josdo/commit-bot/followerschem.png

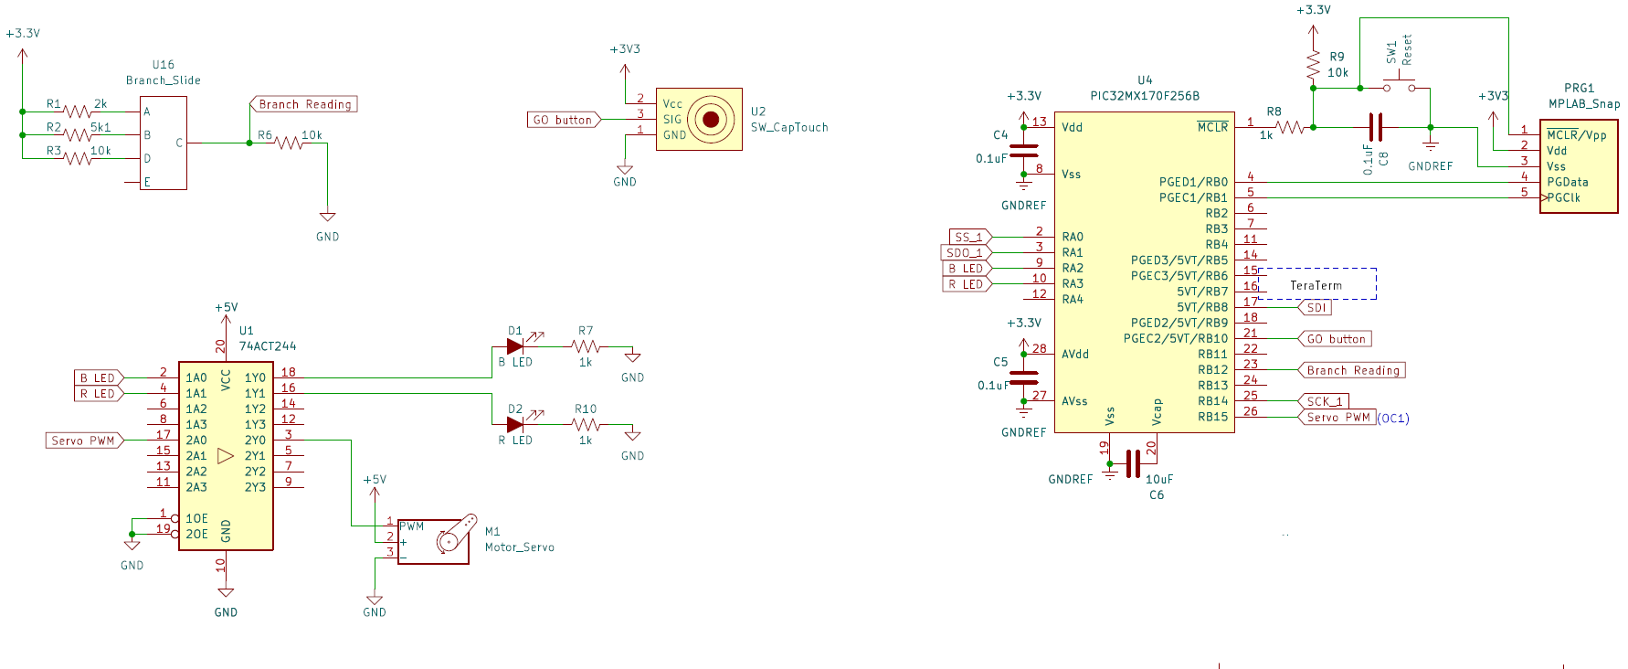
followerschem.png
