josdo/commit-bot/IR.png

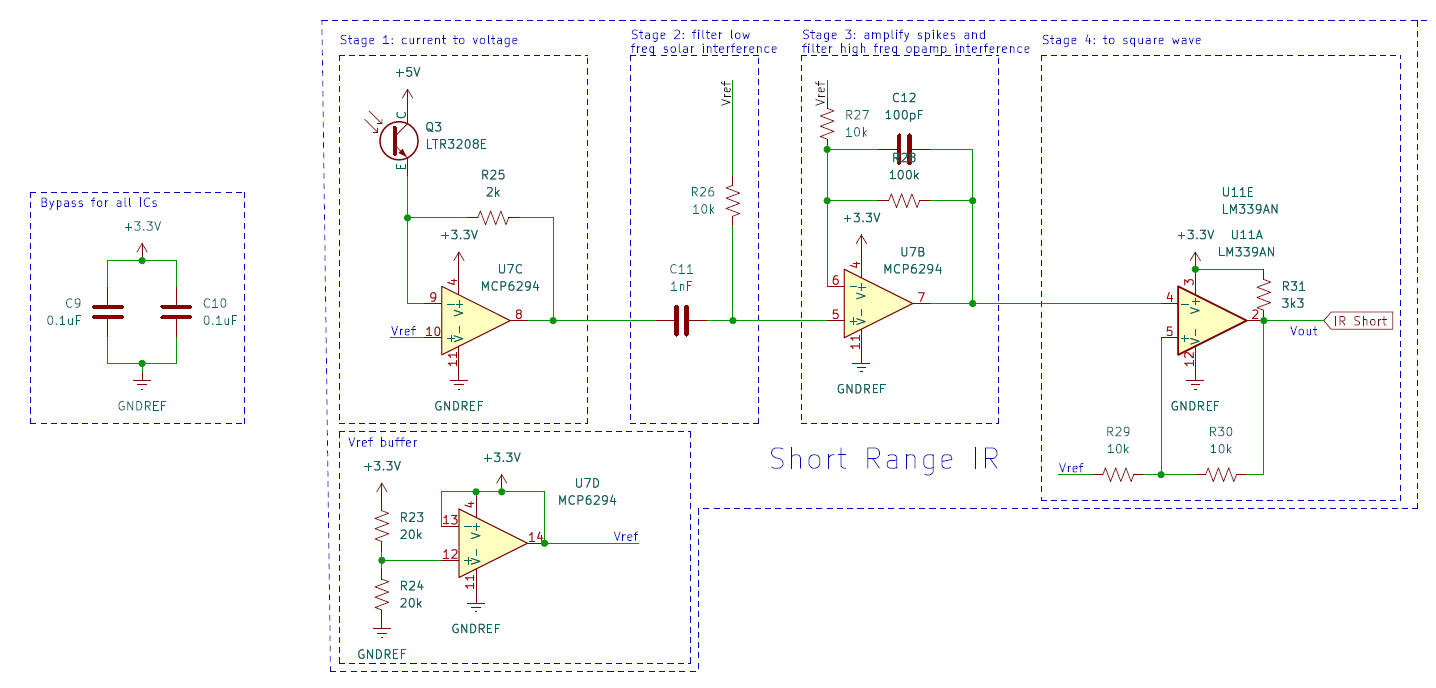
IR.png
