josdo/commit-bot/Leader1.png

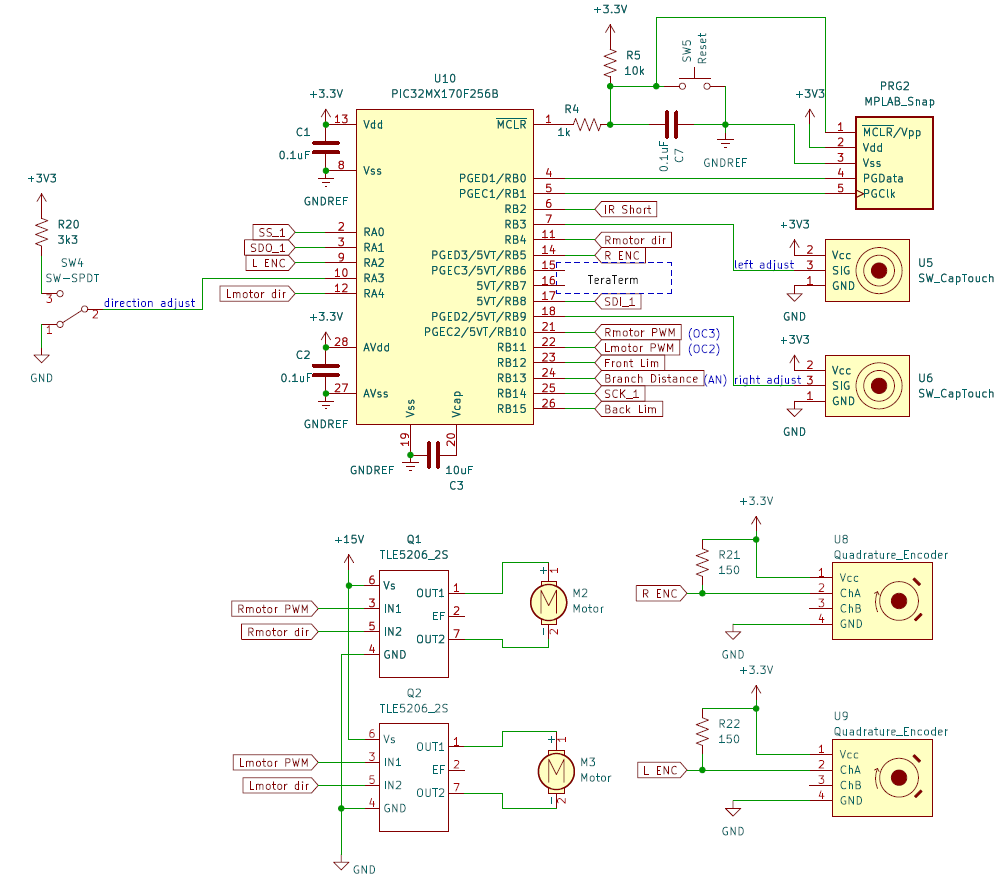
Leader1.png
