josdo/commit-bot/leader2schem.png

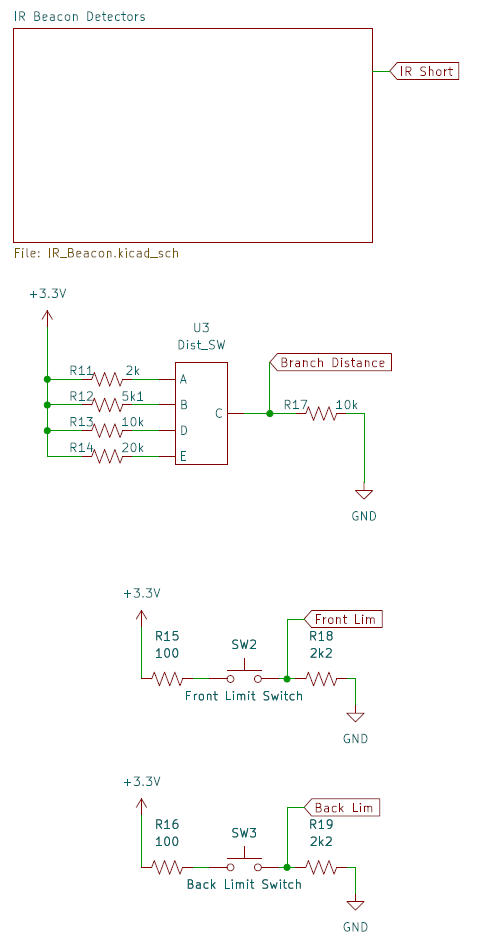
leader2schem.png
