josdo/commit-bot/mechanical/reflect_assem.SLDASM

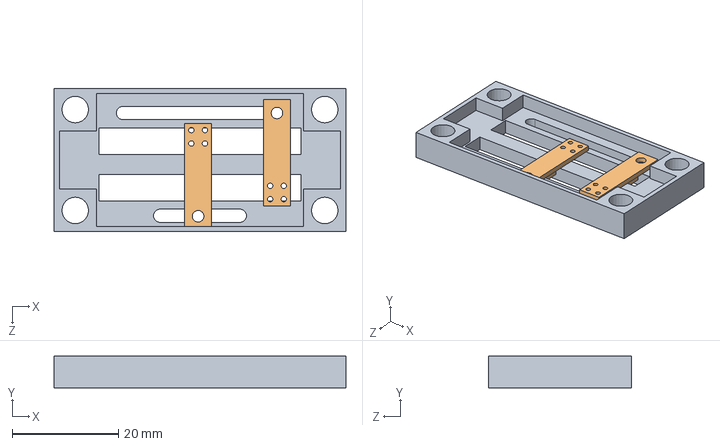
[picture p5: CAD file, 2023-03-14]
mechanical/reflect_assem.SLDASM
55.0 x 6.00 x 27.0 mm
reflectance_holder
Reflectance_Sensor x 2
