josdo/commit-bot/mechanical/NEW_wheel_assem.SLDASM

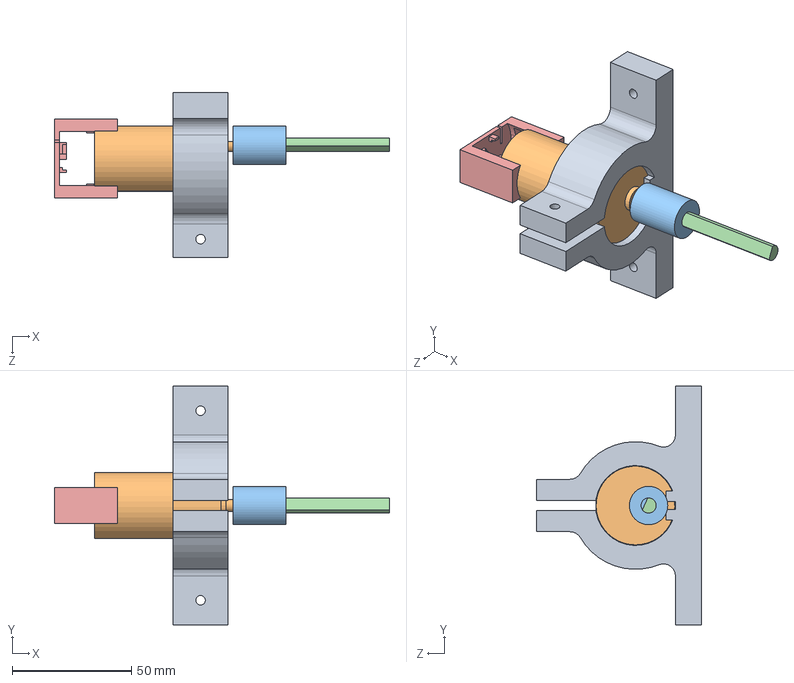
[picture p6: CAD file, 2023-03-14]
mechanical/NEW_wheel_assem.SLDASM
140.4 x 100.0 x 69.2 mm
Motor Mount.ipt
Motor v3.ipt
coupler
drive_shaft
Encoder_BracketMount
