josdo/commit-bot/mechanical/servo_heart.SLDASM

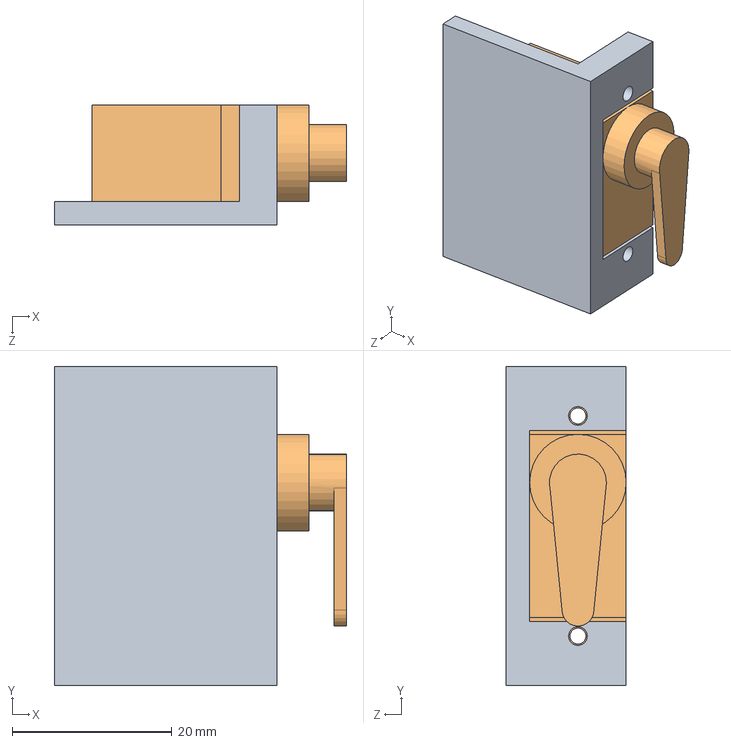
[picture p7: CAD file, 2023-03-13]
mechanical/servo_heart.SLDASM
36.7 x 40.0 x 15.1 mm
servo_holder
servo
