josdo/commit-bot/mechanical/transmission_assem.SLDASM

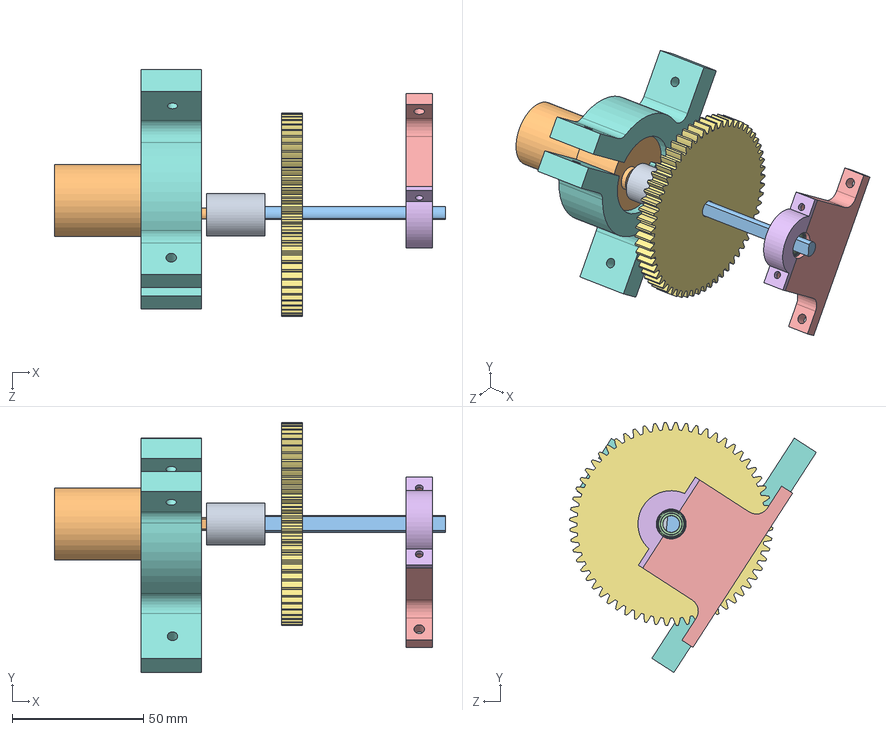
[picture p8: CAD file, 2023-03-08]
mechanical/transmission_assem.SLDASM
149.1 x 95.4 x 94.1 mm
Motor v3.ipt
drive_shaft
coupler
bearing mount
top_bearing_mount
spur gear_am
Mount.ipt
