josdo/commit-bot/mechanical/bearing_mount_assem.SLDASM

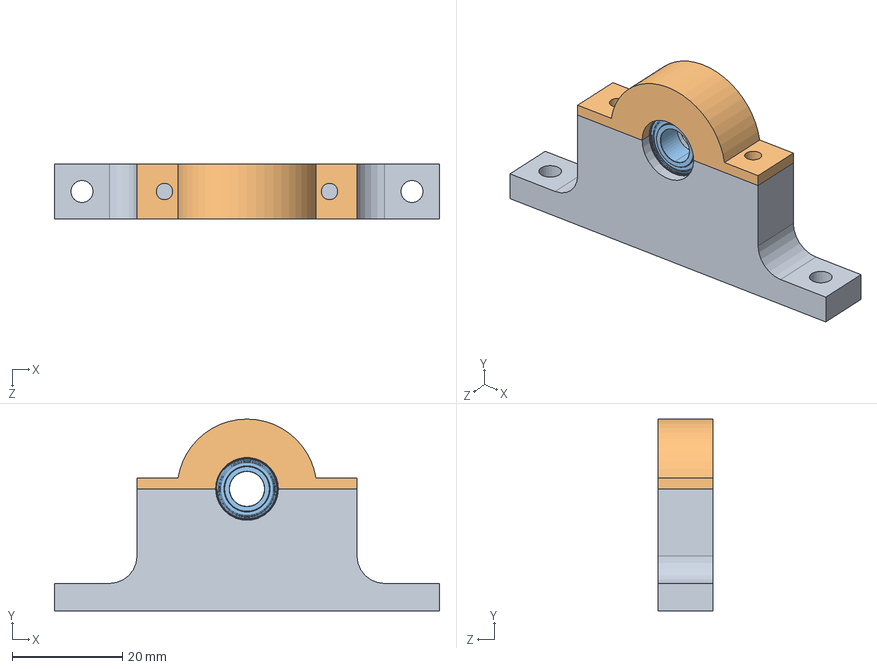
[picture p9: CAD file, 2023-03-08]
mechanical/bearing_mount_assem.SLDASM
70.0 x 34.9 x 10.0 mm
short_bearing_mount
top_bearing_mount
1600-0002-0250.step
