josdo/commit-bot/mechanical/wheel_mount.SLDASM

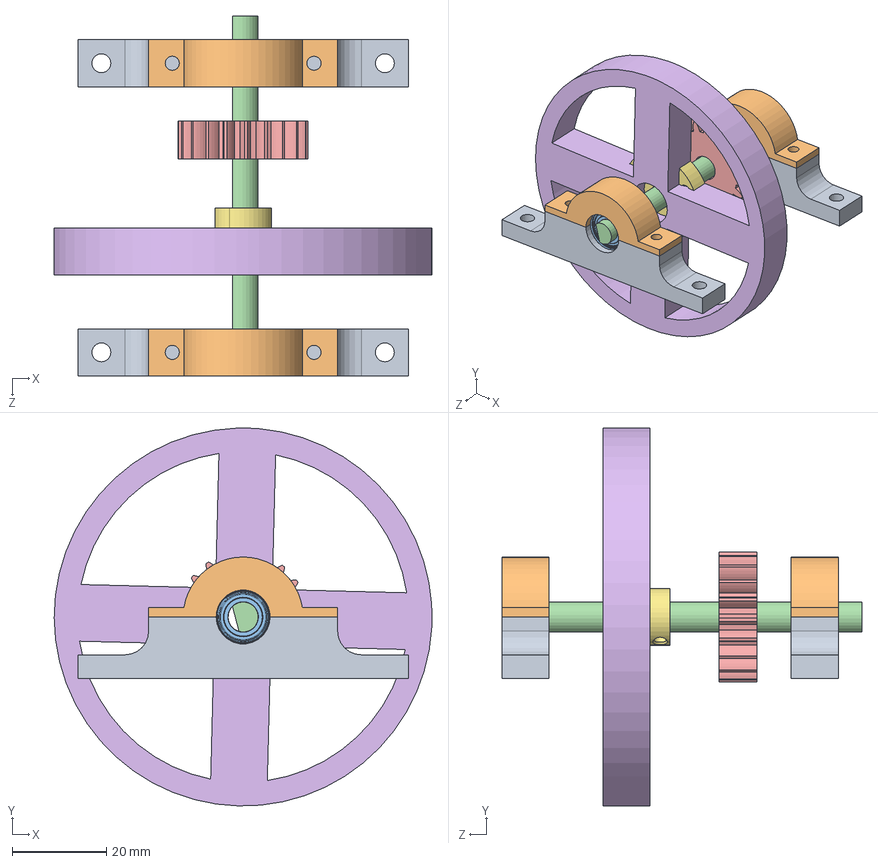
[picture p10: CAD file, 2023-02-17]
mechanical/wheel_mount.SLDASM
79.9 x 80.0 x 76.2 mm
short_bearing_mount x 2
top_bearing_mount x 2
1600-0002-0250.step x 2
drive_shaft
spur gear_am
wheel_80mm
pololu-universal-aluminum-mounting-hub-for-0-25in-shaft-m3-holes.step
