josdo/commit-bot/mechanical/total_robot.SLDASM

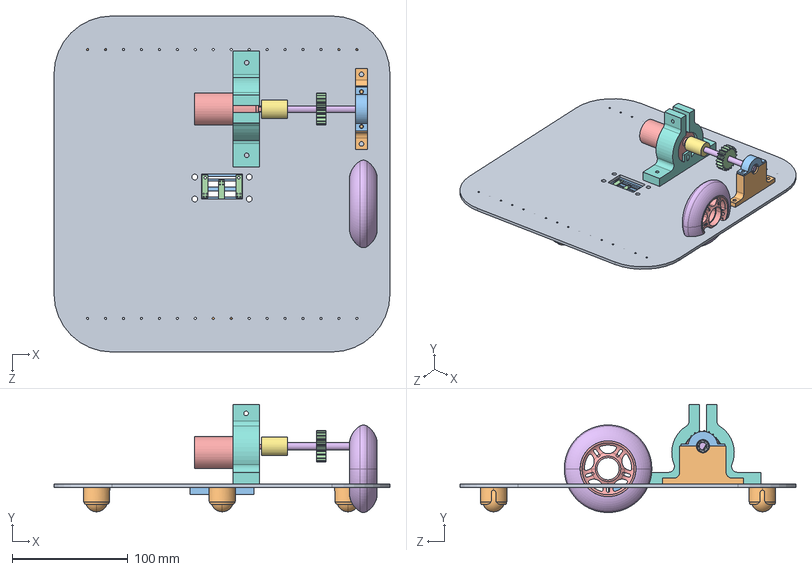
[picture p11: CAD file, 2023-02-16]
mechanical/total_robot.SLDASM
290.0 x 93.2 x 290.0 mm
DEV_bottom_board
pololu-ball-caster-with-0-750in-metal-ball.step x 3
reflectance_holder
Reflectance_Sensor x 3
Motor v3.ipt
drive_shaft
coupler
Mount.ipt
1600-0002-0250.step
bearing mount
top_bearing_mount
spur gear_am
3608-0001-0076 pt1.STEP
3608-0001-0076 pt2.STEP
