josdo/commit-bot/mechanical/3608-0001-0076 assembly.STEP

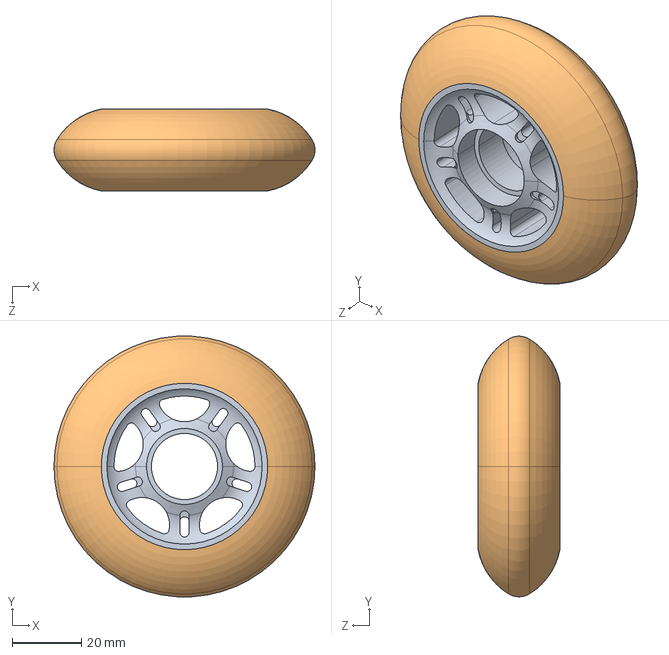
[picture p12: CAD file, 2023-02-16]
mechanical/3608-0001-0076 assembly.STEP
75.5 x 75.4 x 23.7 mm
3608-0001-0076 pt1
3608-0001-0076 pt2
