josdo/commit-bot/mechanical/STLs/right_heart.STL

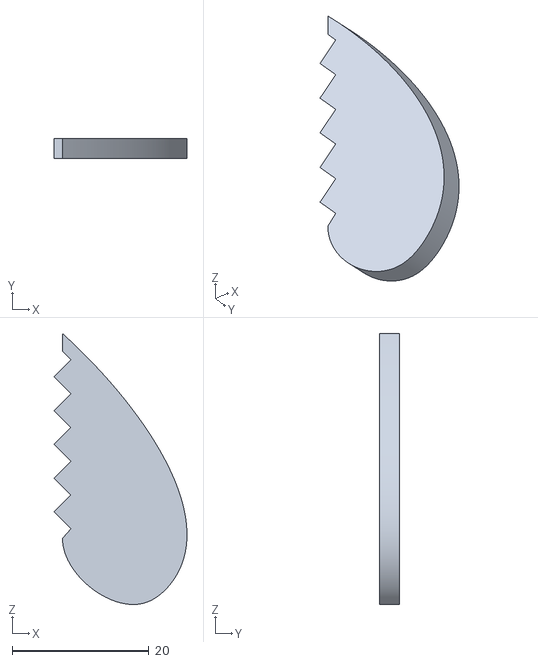
[picture p13: CAD file, 2023-03-13]
mechanical/STLs/right_heart.STL
19.5 x 3.00 x 39.7
