josdo/commit-bot/mechanical/NEW_top_plate.SLDPRT

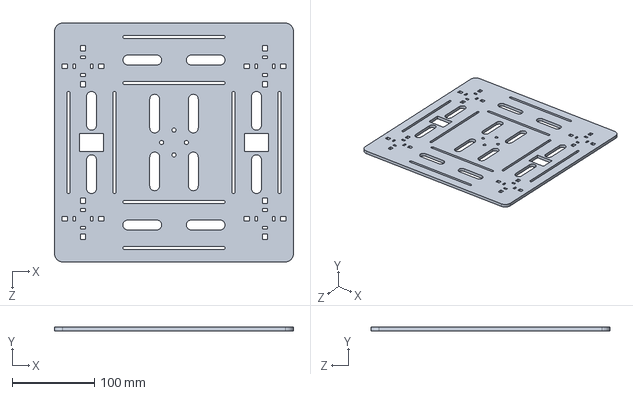
[picture p14: CAD file, 2023-03-14]
mechanical/NEW_top_plate.SLDPRT
290.0 x 4.76 x 290.0 mm
