josdo/commit-bot/mechanical/STLs/spur_D_40.STL

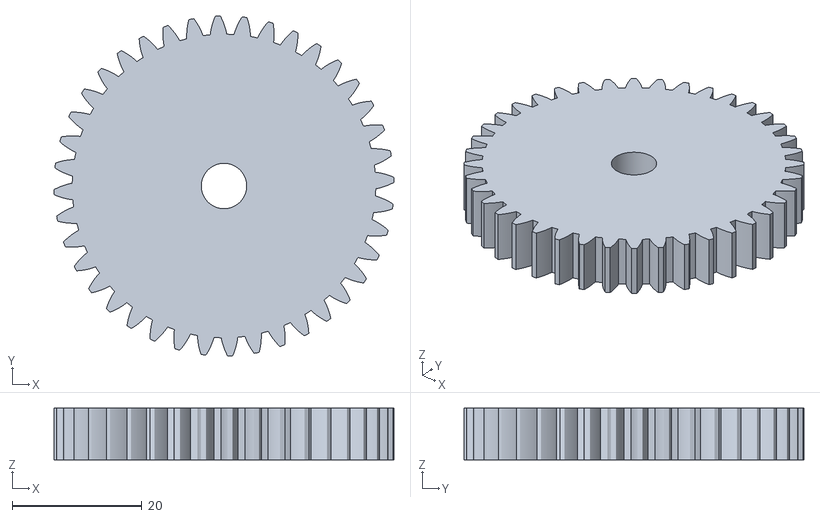
[picture p15: CAD file, 2023-02-17]
mechanical/STLs/spur_D_40.STL
52.5 x 52.5 x 8.00
