josdo/commit-bot/mechanical/reflectance_holder.SLDPRT

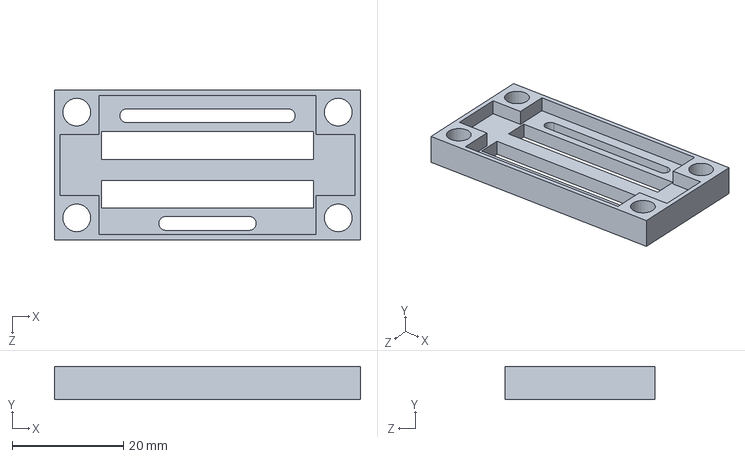
[picture p16: CAD file, 2023-03-14]
mechanical/reflectance_holder.SLDPRT
55.0 x 6.00 x 27.0 mm
