josdo/commit-bot/mechanical/STLs/Encoder_MagnetMount.STL

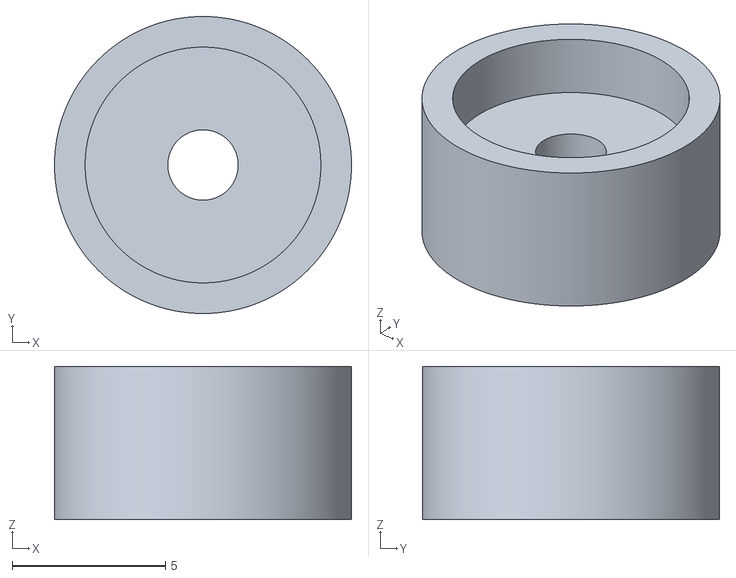
[picture p17: CAD file, 2023-02-17]
mechanical/STLs/Encoder_MagnetMount.STL
9.70 x 9.70 x 5.00
