josdo/commit-bot/mechanical/limit_switch.SLDPRT

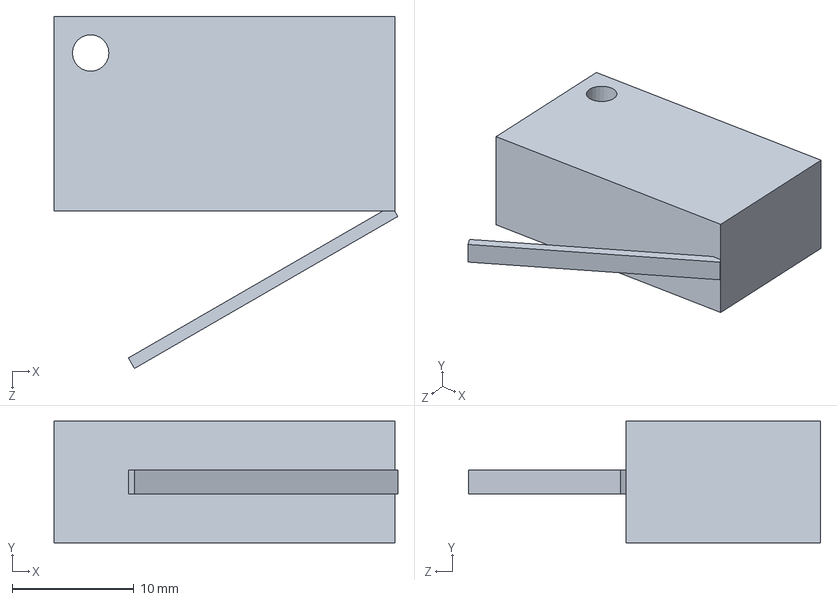
[picture p18: CAD file, 2023-03-14]
mechanical/limit_switch.SLDPRT
28.2 x 10.0 x 28.9 mm
