josdo/commit-bot/mechanical/STLs/bottom_bearing_tall.STL

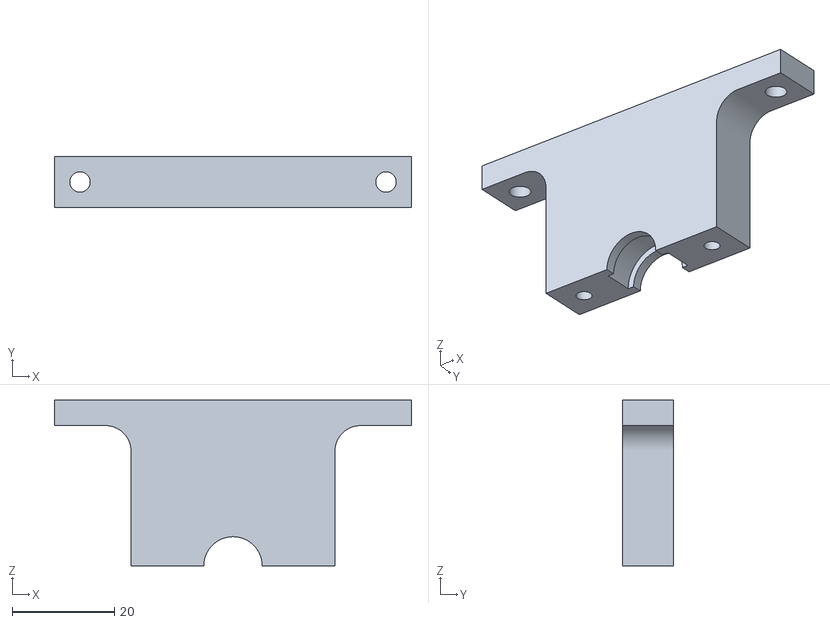
[picture p19: CAD file, 2023-02-17]
mechanical/STLs/bottom_bearing_tall.STL
70.0 x 10.0 x 32.5
