josdo/commit-bot/mechanical/large_protoboard_adafruit.SLDPRT

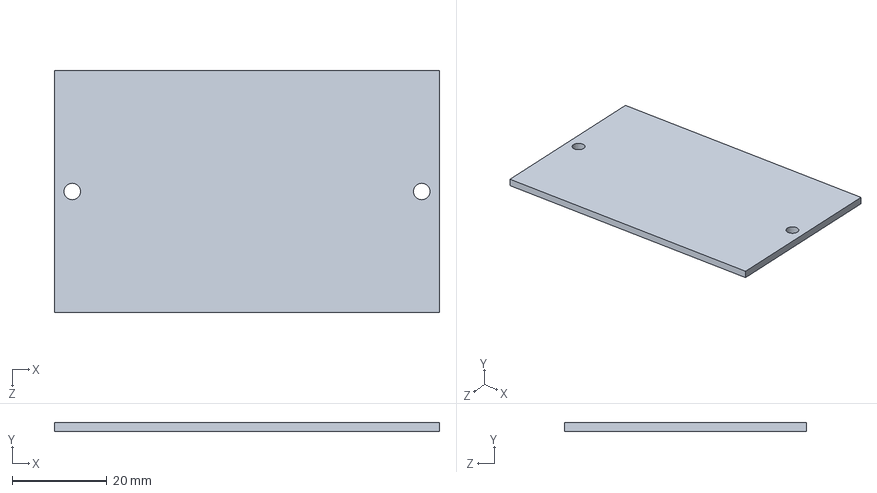
[picture p20: CAD file, 2023-03-14]
mechanical/large_protoboard_adafruit.SLDPRT
81.3 x 2.00 x 51.0 mm
