josdo/commit-bot/mechanical/protoboard.SLDPRT

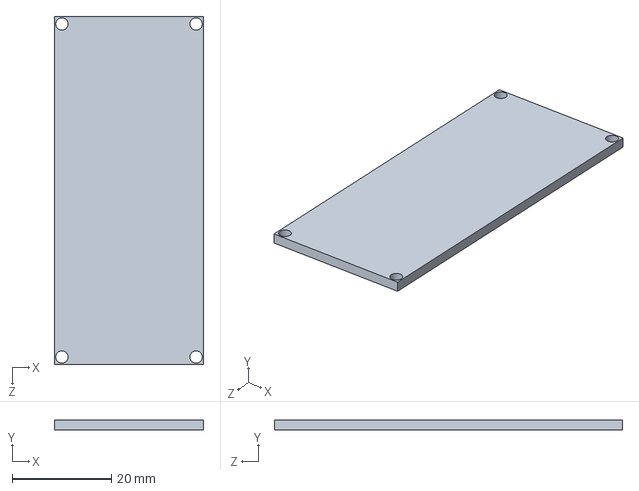
[picture p21: CAD file, 2023-03-14]
mechanical/protoboard.SLDPRT
30.0 x 2.00 x 70.0 mm
