josdo/commit-bot/mechanical/cap_touch.SLDPRT

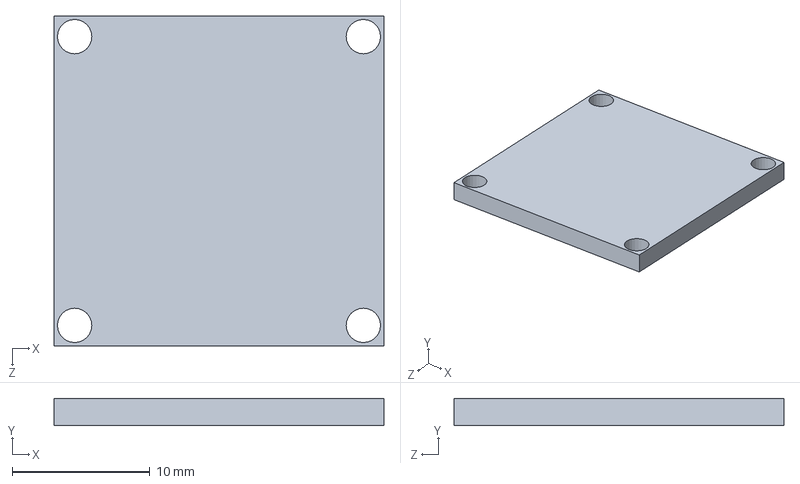
[picture p22: CAD file, 2023-03-14]
mechanical/cap_touch.SLDPRT
24.0 x 2.00 x 24.0 mm
