josdo/commit-bot/mechanical/5v_battery.SLDPRT

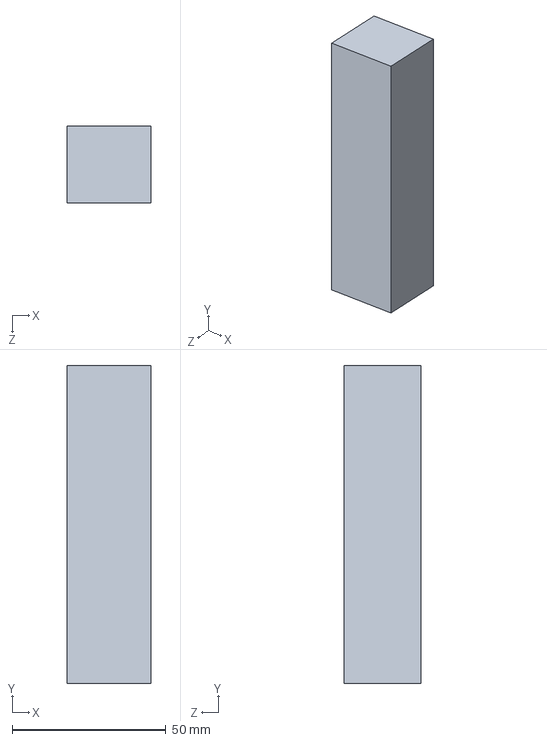
[picture p23: CAD file, 2023-03-14]
mechanical/5v_battery.SLDPRT
27.3 x 103.5 x 25.0 mm
