josdo/commit-bot/mechanical/small_protoboard_adafruit.SLDPRT

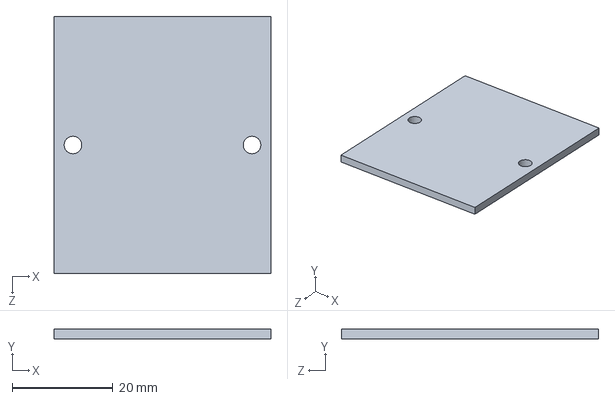
[picture p24: CAD file, 2023-03-14]
mechanical/small_protoboard_adafruit.SLDPRT
43.0 x 2.00 x 51.0 mm
