josdo/commit-bot/mechanical/Encoder_BracketMount.SLDPRT

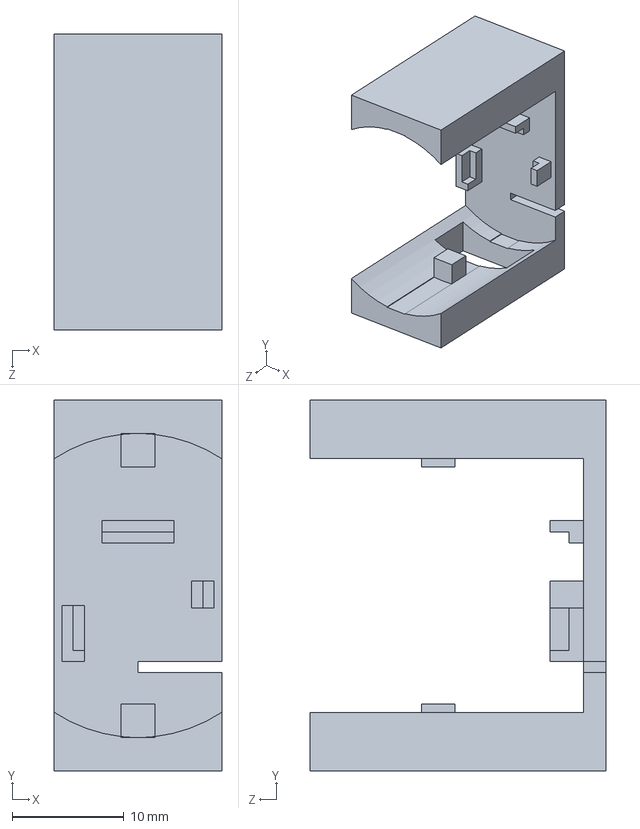
[picture p25: CAD file, 2023-03-14]
mechanical/Encoder_BracketMount.SLDPRT
15.0 x 33.2 x 26.5 mm
