josdo/commit-bot/mechanical/servo.SLDPRT

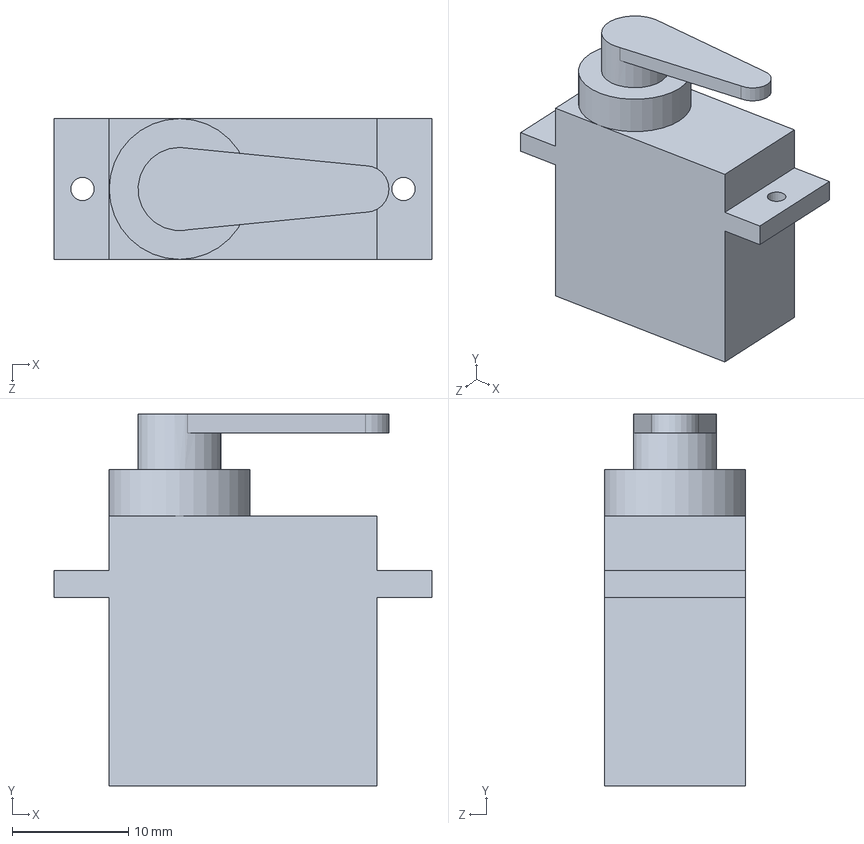
[picture p26: CAD file, 2023-03-13]
mechanical/servo.SLDPRT
32.5 x 32.0 x 12.1 mm
