josdo/commit-bot/mechanical/power_switch.SLDPRT

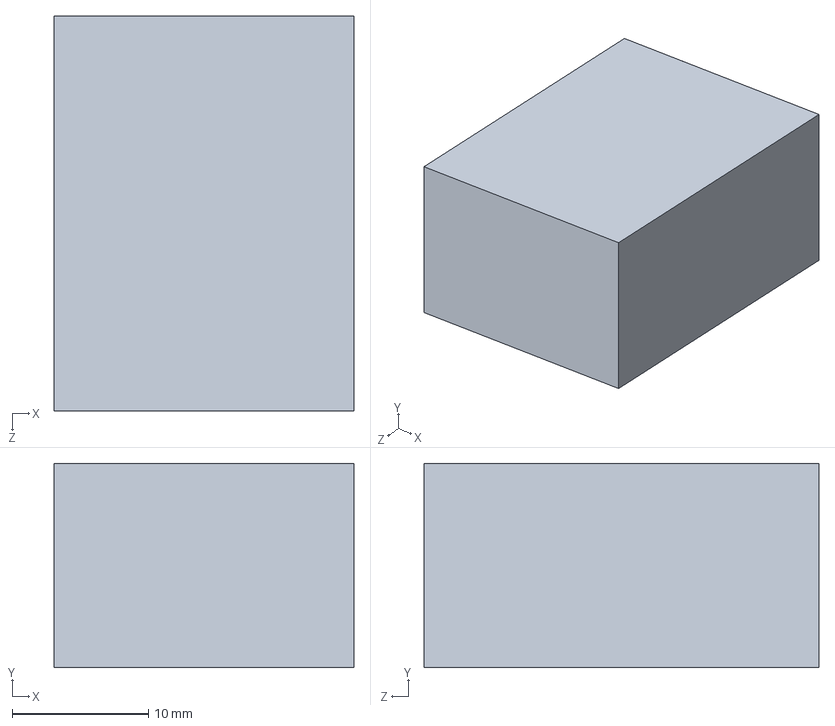
[picture p27: CAD file, 2023-03-13]
mechanical/power_switch.SLDPRT
22.0 x 15.0 x 29.0 mm
