josdo/commit-bot/mechanical/servo_holder.SLDPRT

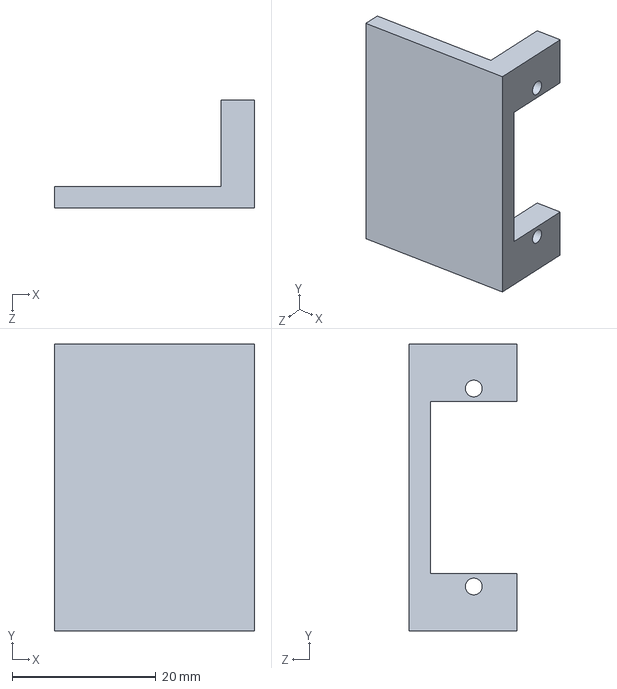
[picture p28: CAD file, 2023-03-13]
mechanical/servo_holder.SLDPRT
27.9 x 40.0 x 15.1 mm
