josdo/commit-bot/mechanical/motor_driver_board.SLDPRT

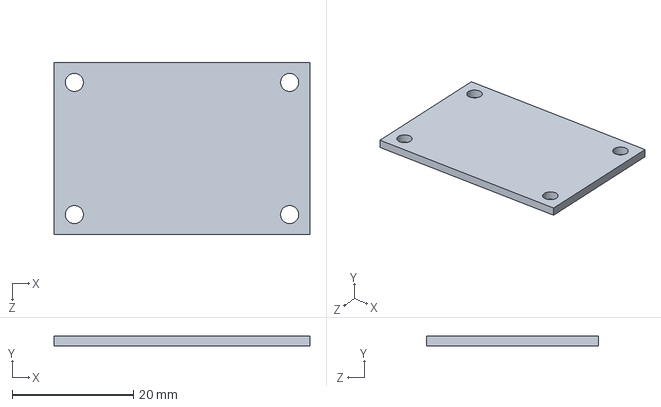
[picture p29: CAD file, 2023-03-13]
mechanical/motor_driver_board.SLDPRT
42.3 x 1.60 x 28.5 mm
