josdo/commit-bot/mechanical/drive_shaft.SLDPRT

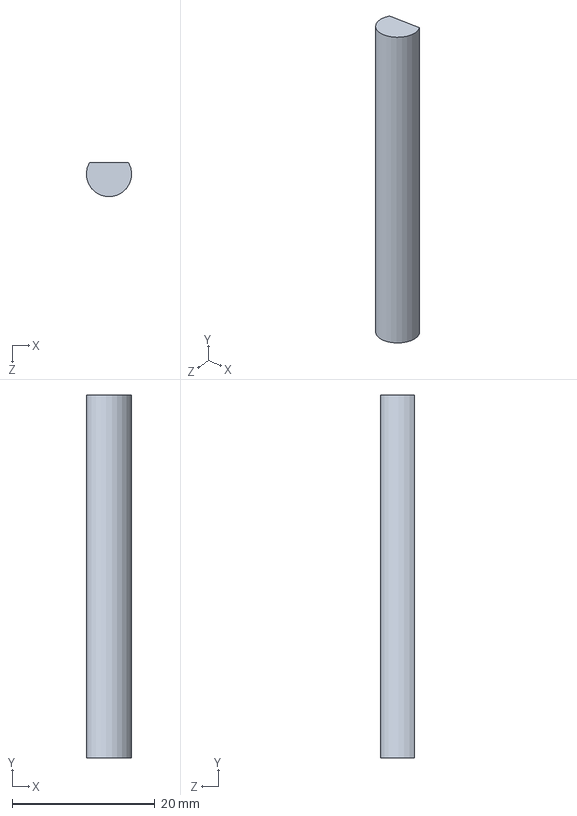
[picture p30: CAD file, 2023-03-13]
mechanical/drive_shaft.SLDPRT
6.34 x 50.8 x 4.77 mm
