josdo/commit-bot/mechanical/beacon_sensor.SLDPRT

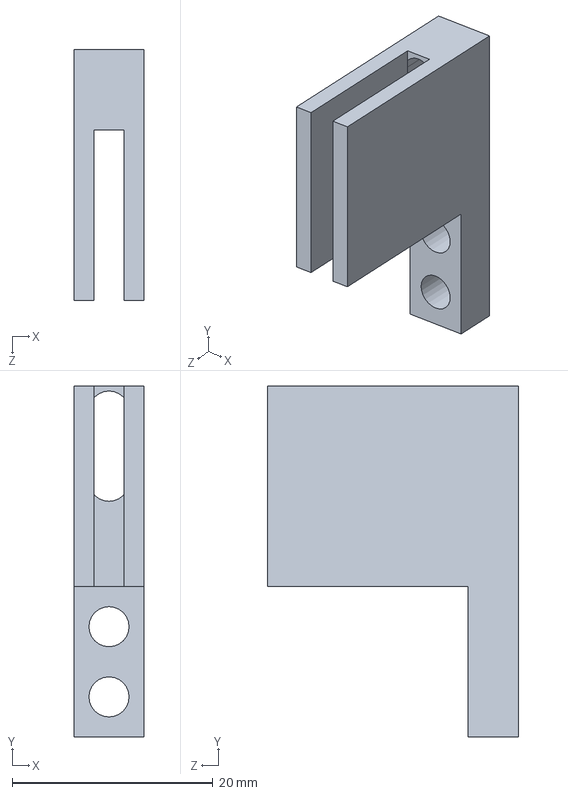
[picture p31: CAD file, 2023-03-08]
mechanical/beacon_sensor.SLDPRT
7.00 x 35.0 x 25.0 mm
