josdo/commit-bot/mechanical/supports.SLDPRT

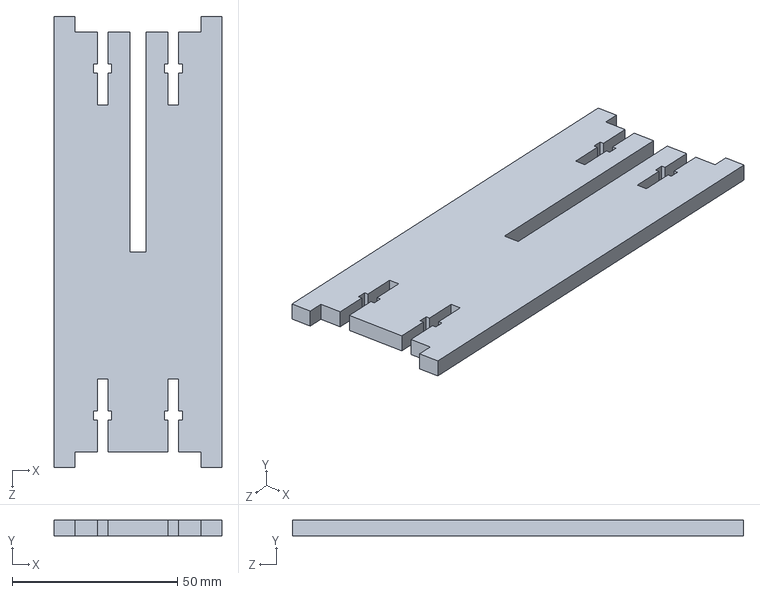
[picture p32: CAD file, 2023-03-08]
mechanical/supports.SLDPRT
50.8 x 4.76 x 136.5 mm
