josdo/commit-bot/mechanical/standoff.SLDPRT

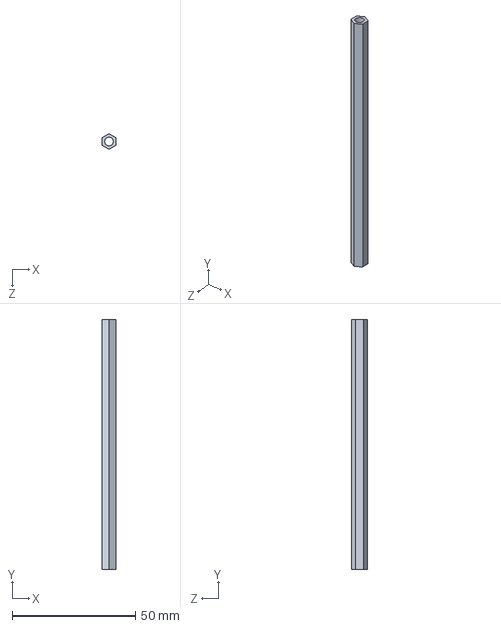
[picture p33: CAD file, 2023-03-08]
mechanical/standoff.SLDPRT
5.50 x 101.6 x 6.35 mm
