josdo/commit-bot/mechanical/beacon_tower.SLDPRT

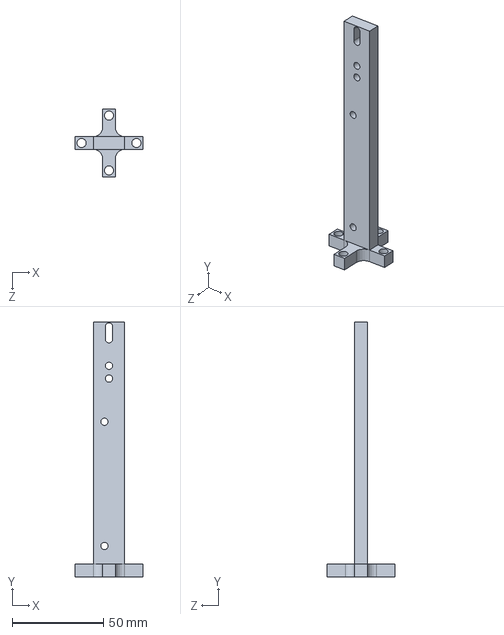
[picture p34: CAD file, 2023-03-08]
mechanical/beacon_tower.SLDPRT
37.0 x 139.7 x 37.0 mm
