josdo/commit-bot/mechanical/top_plate.SLDPRT

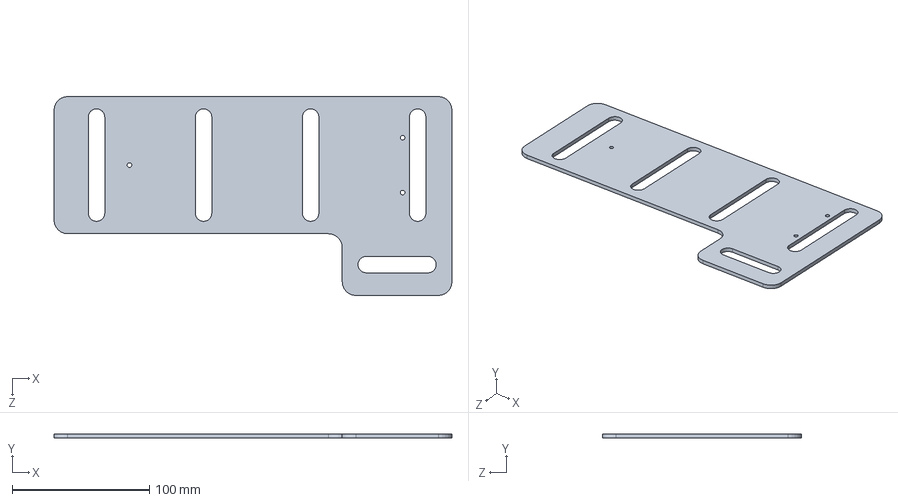
[picture p35: CAD file, 2023-03-08]
mechanical/top_plate.SLDPRT
290.0 x 3.17 x 145.0 mm
