josdo/commit-bot/mechanical/wall_mount_2.SLDPRT

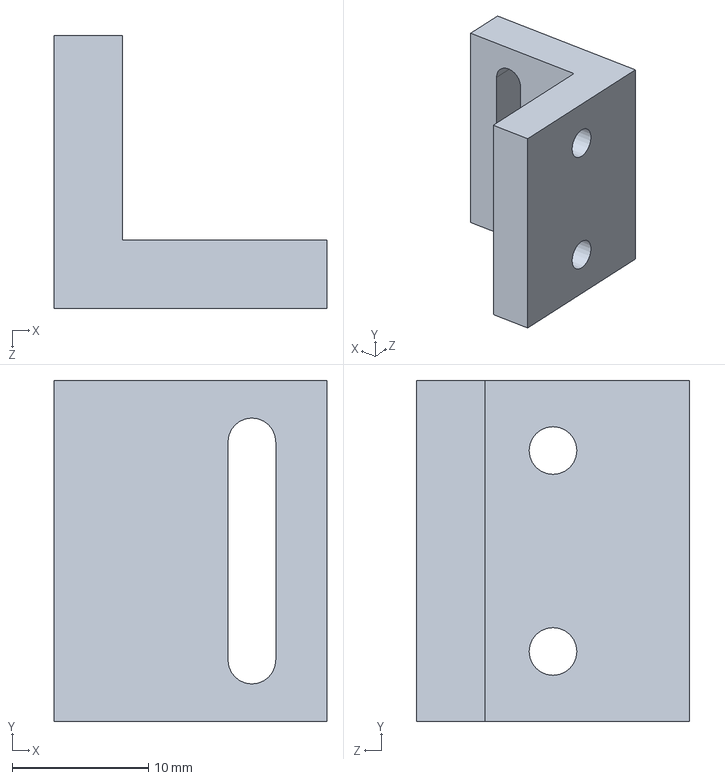
[picture p36: CAD file, 2023-03-08]
mechanical/wall_mount_2.SLDPRT
20.0 x 25.0 x 20.0 mm
