josdo/commit-bot/mechanical/short_bearing_mount.SLDPRT

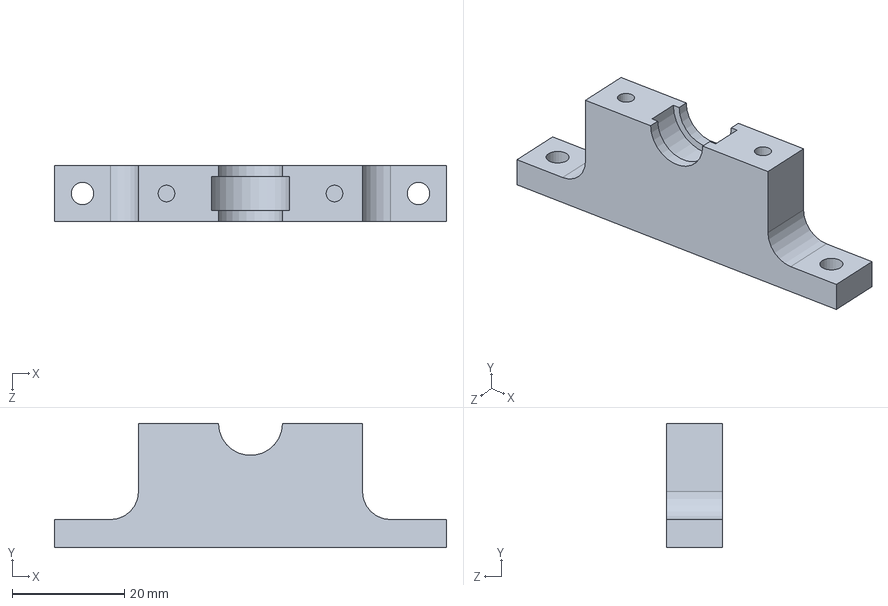
[picture p37: CAD file, 2023-03-08]
mechanical/short_bearing_mount.SLDPRT
70.0 x 22.2 x 10.0 mm
