josdo/commit-bot/mechanical/PIC_board.SLDPRT

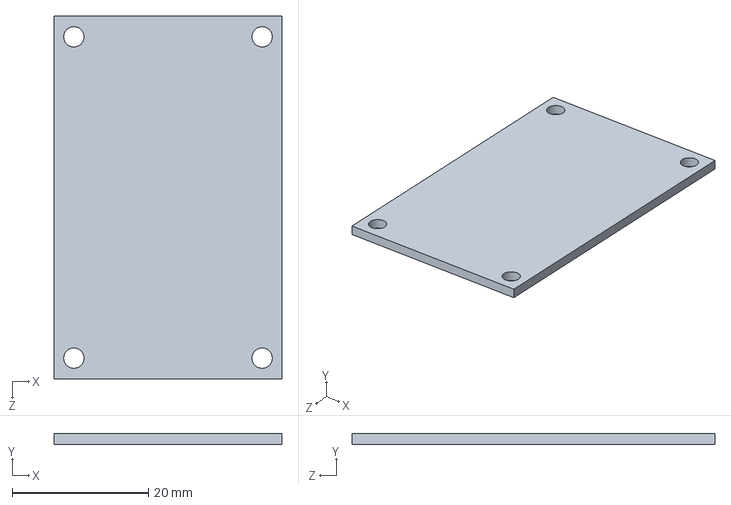
[picture p38: CAD file, 2023-03-08]
mechanical/PIC_board.SLDPRT
33.5 x 1.60 x 53.3 mm
