josdo/commit-bot/mechanical/PDB.SLDPRT

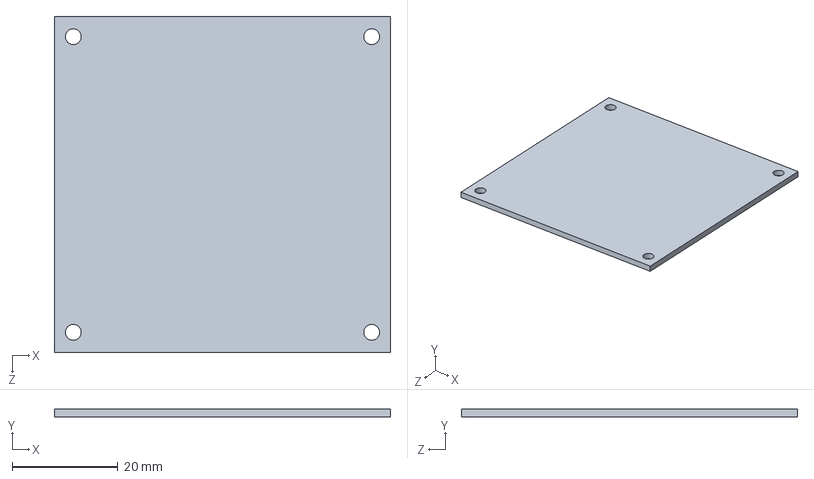
[picture p39: CAD file, 2023-03-08]
mechanical/PDB.SLDPRT
63.5 x 1.60 x 63.5 mm
