josdo/commit-bot/mechanical/battery.SLDPRT

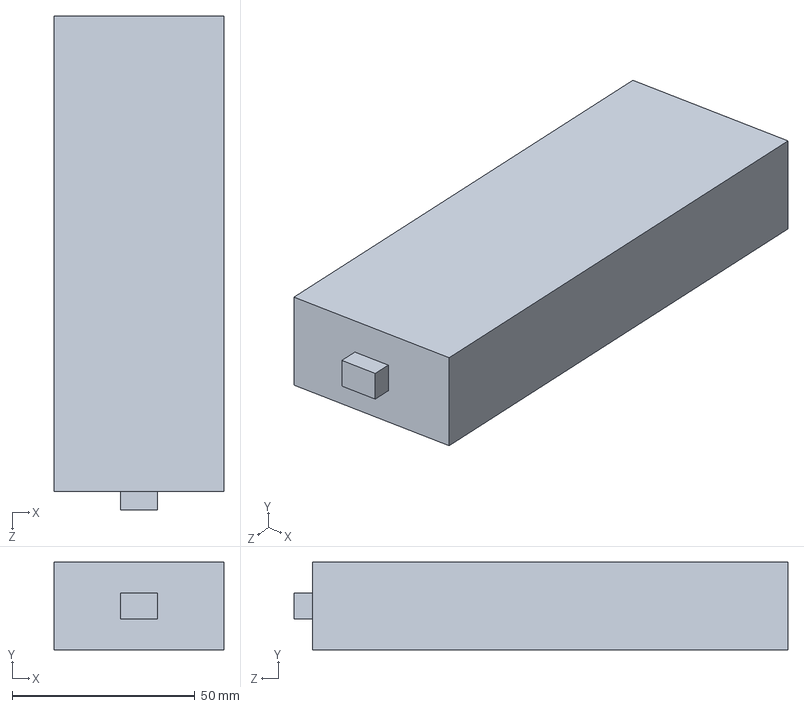
[picture p40: CAD file, 2023-03-08]
mechanical/battery.SLDPRT
46.5 x 24.0 x 135.0 mm
