josdo/commit-bot/mechanical/signal_condition_board.SLDPRT

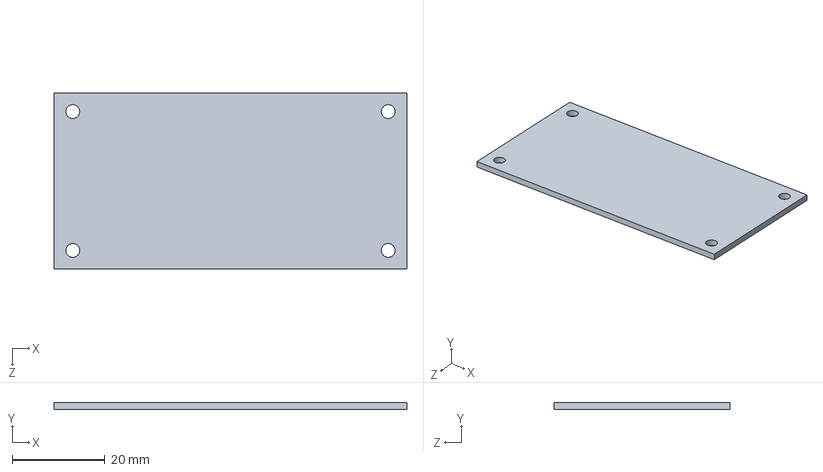
[picture p41: CAD file, 2023-03-08]
mechanical/signal_condition_board.SLDPRT
76.2 x 1.60 x 38.1 mm
