josdo/commit-bot/mechanical/Motor Mount.SLDPRT

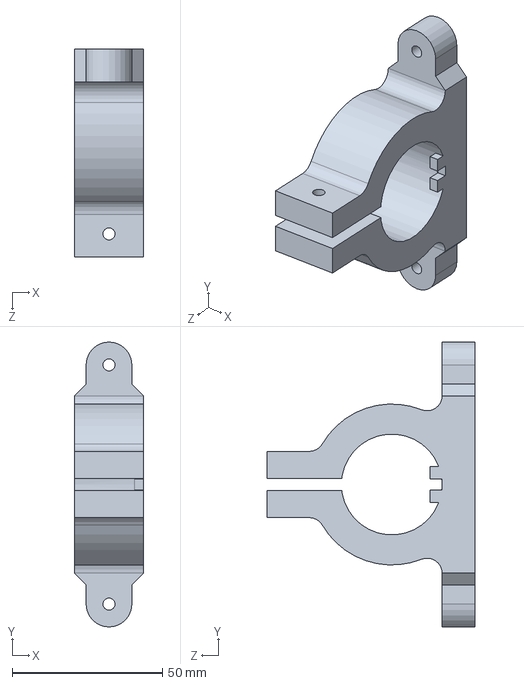
[picture p42: CAD file, 2023-02-19]
mechanical/Motor Mount.SLDPRT
23.0 x 94.7 x 69.2 mm
