josdo/commit-bot/mechanical/pololu-universal-aluminum-mounting-hub-for-0-25in-shaft-m3-holes.step

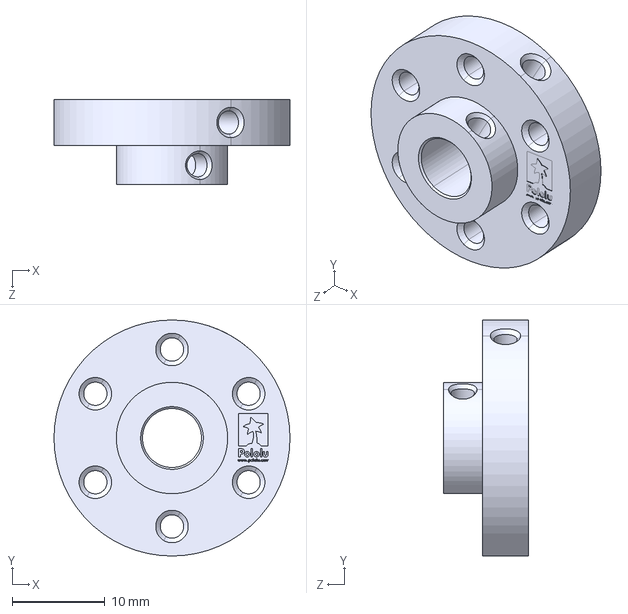
[picture p43: CAD file, 2023-02-17]
mechanical/pololu-universal-aluminum-mounting-hub-for-0-25in-shaft-m3-holes.step
25.4 x 25.4 x 9.20 mm
