josdo/commit-bot/mechanical/wheel_80mm.SLDPRT

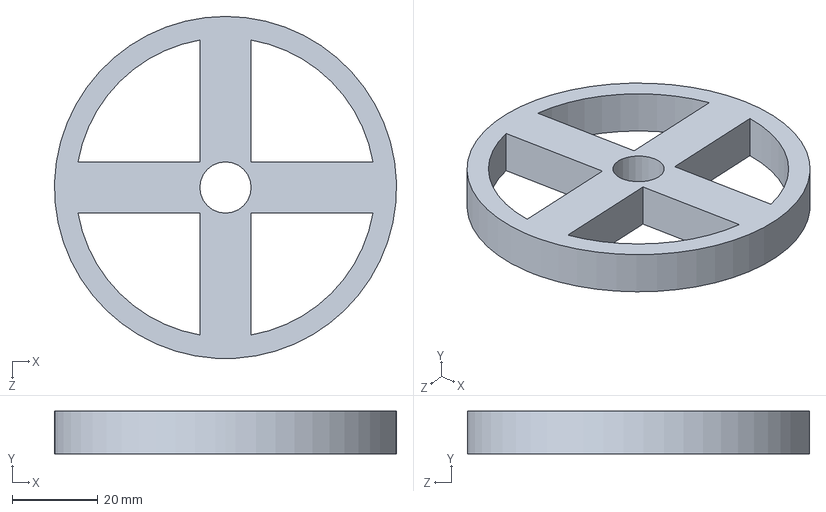
[picture p44: CAD file, 2023-02-17]
mechanical/wheel_80mm.SLDPRT
80.0 x 10.0 x 80.0 mm
