josdo/commit-bot/mechanical/spur_20_D.SLDPRT

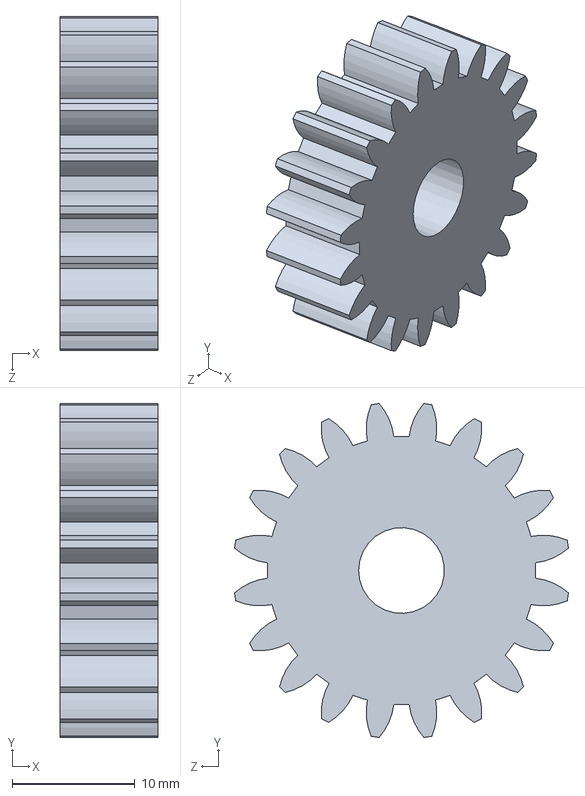
[picture p45: CAD file, 2023-02-17]
mechanical/spur_20_D.SLDPRT
8.00 x 27.3 x 27.3 mm
