josdo/commit-bot/mechanical/top_bearing_mount.SLDPRT

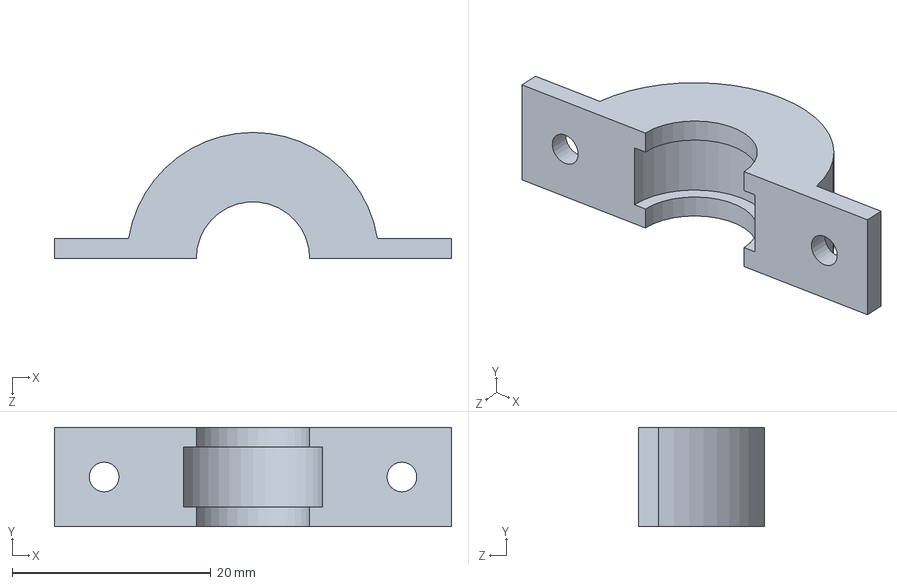
[picture p46: CAD file, 2023-02-17]
mechanical/top_bearing_mount.SLDPRT
40.0 x 10.0 x 12.7 mm
