josdo/commit-bot/mechanical/spur_40_D.SLDPRT

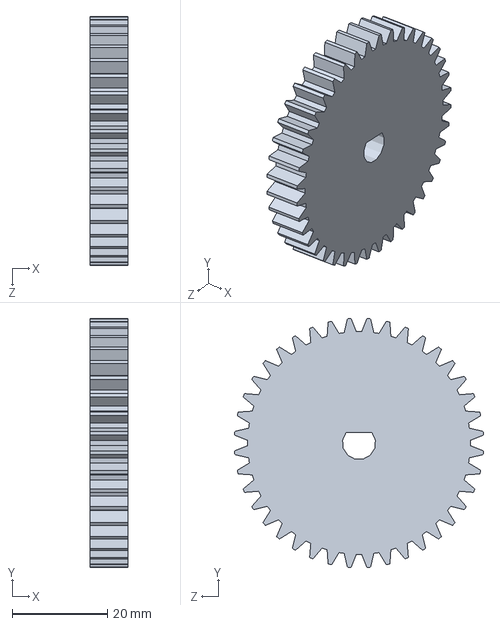
[picture p47: CAD file, 2023-02-17]
mechanical/spur_40_D.SLDPRT
8.00 x 52.4 x 52.4 mm
