josdo/commit-bot/mechanical/pololu-ball-caster-with-0-500in-ball.step

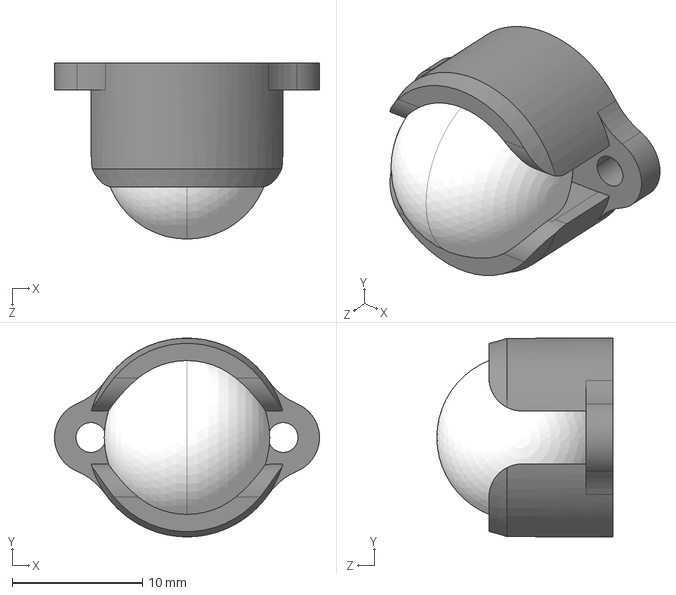
[picture p48: CAD file, 2023-02-17]
mechanical/pololu-ball-caster-with-0-500in-ball.step
20.3 x 15.2 x 13.5 mm
