josdo/commit-bot/mechanical/gear_coupler.SLDPRT

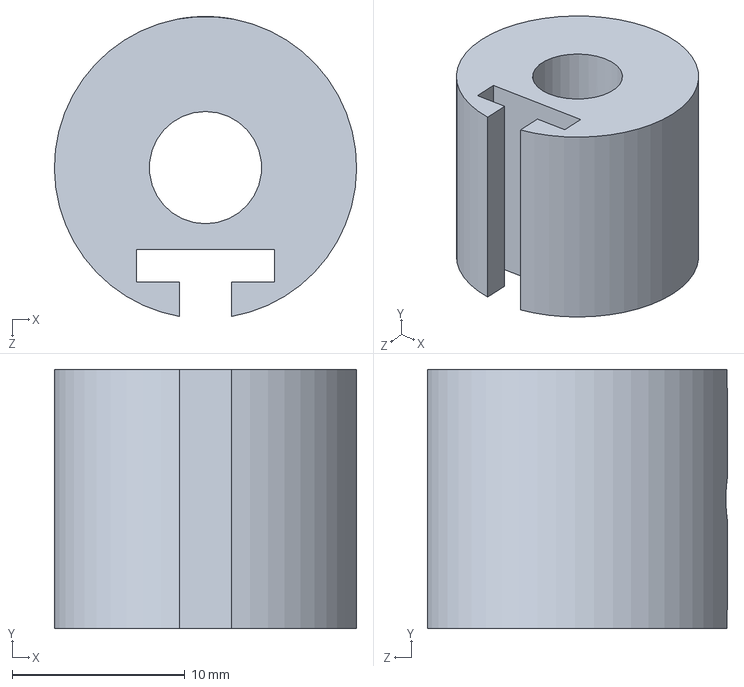
[picture p49: CAD file, 2023-02-16]
mechanical/gear_coupler.SLDPRT
17.5 x 15.0 x 17.4 mm
