josdo/commit-bot/mechanical/slider.SLDPRT

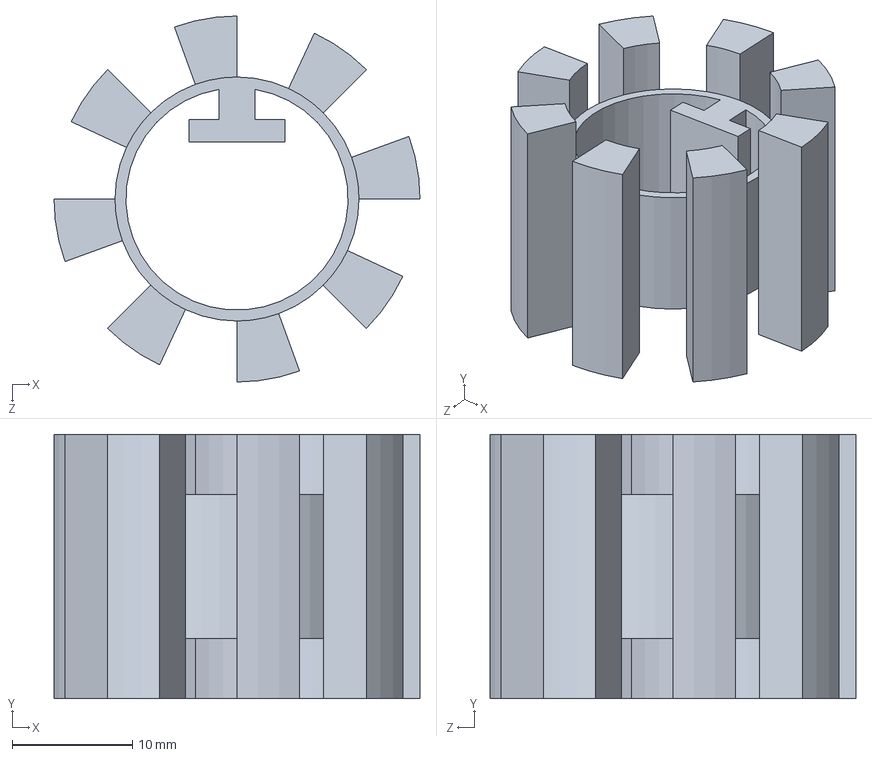
[picture p50: CAD file, 2023-02-16]
mechanical/slider.SLDPRT
30.5 x 22.0 x 30.5 mm
