josdo/commit-bot/mechanical/coupler.SLDPRT

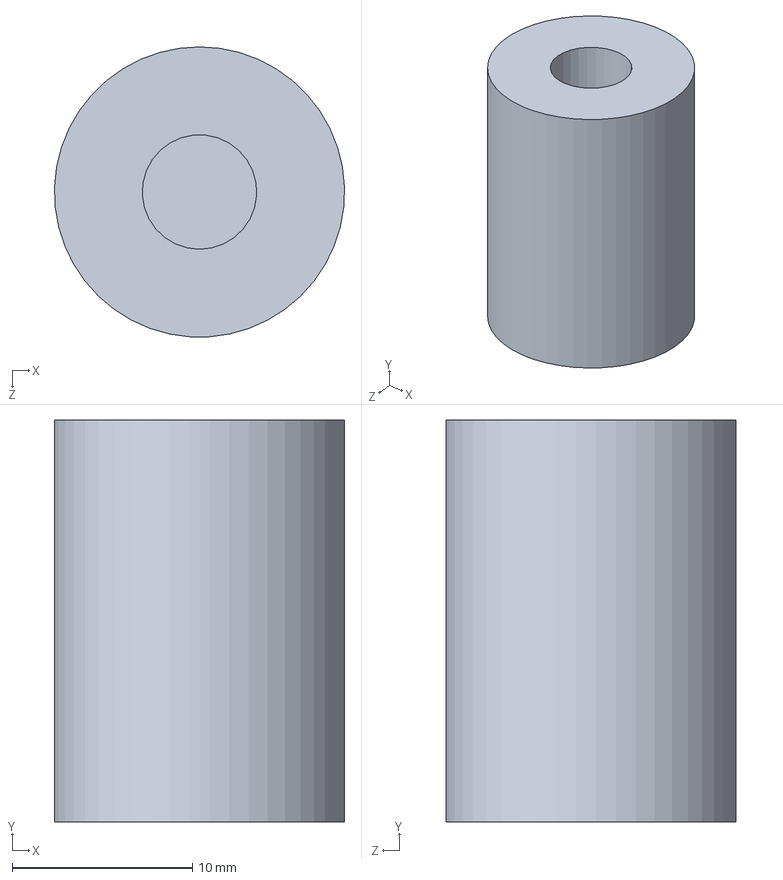
[picture p51: CAD file, 2023-02-16]
mechanical/coupler.SLDPRT
16.1 x 22.3 x 16.1 mm
