josdo/commit-bot/mechanical/1600-0002-0250.STEP

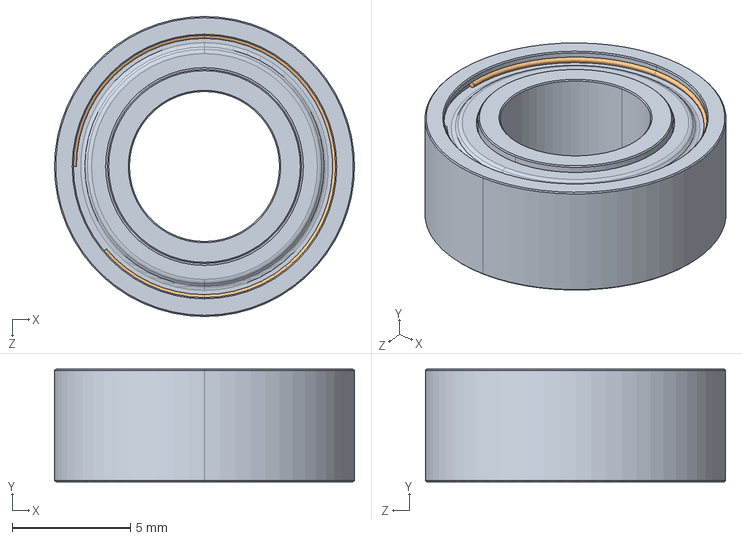
[picture p52: CAD file, 2023-02-16]
mechanical/1600-0002-0250.STEP
12.7 x 4.76 x 12.7 mm
