josdo/commit-bot/mechanical/Reflectance_Sensor.SLDPRT

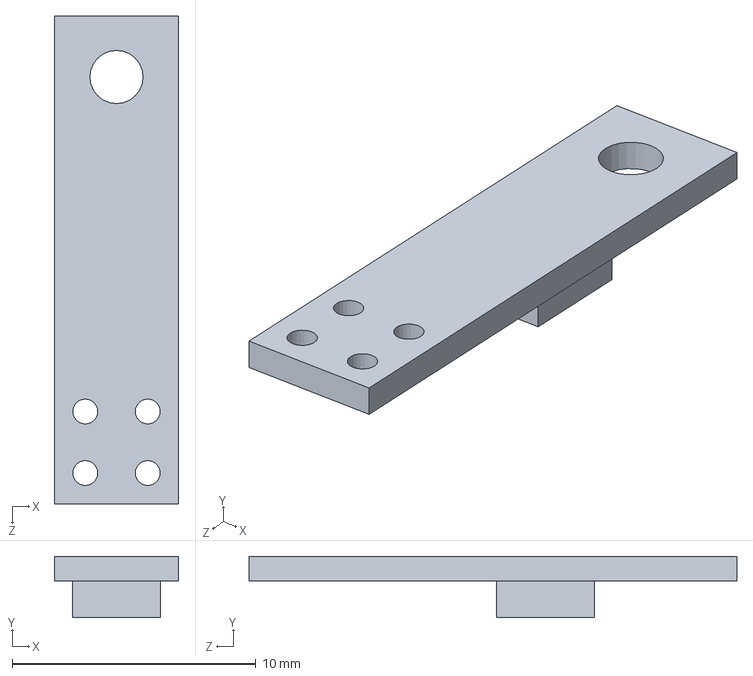
[picture p53: CAD file, 2023-02-14]
mechanical/Reflectance_Sensor.SLDPRT
5.10 x 2.52 x 20.0 mm
