josdo/commit-bot/mechanical/pololu-ball-caster-with-0-750in-metal-ball.step

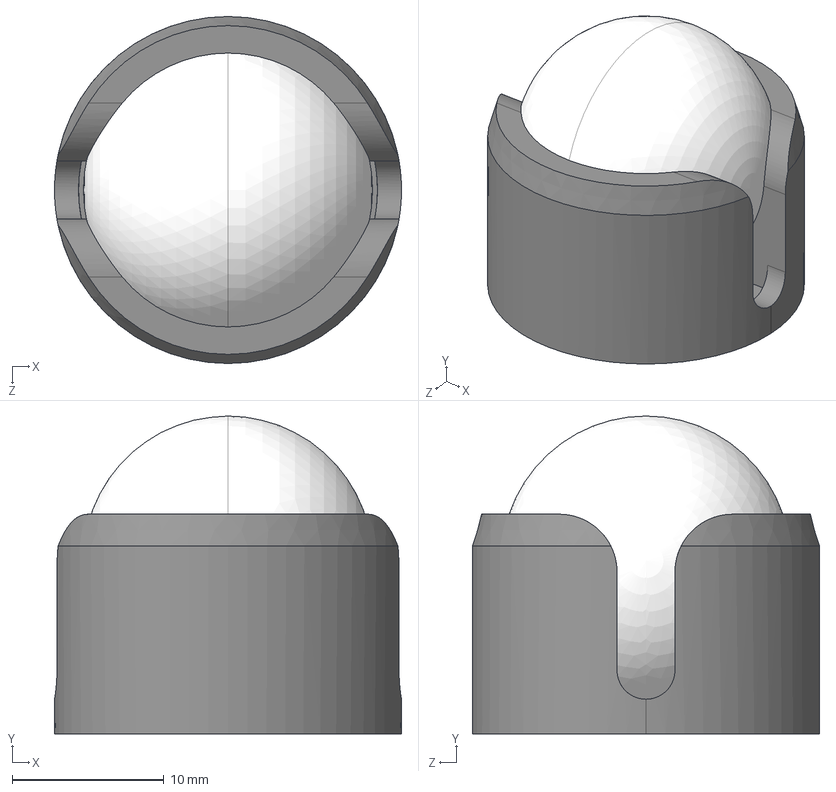
[picture p54: CAD file, 2023-02-14]
mechanical/pololu-ball-caster-with-0-750in-metal-ball.step
22.9 x 20.9 x 22.9 mm
