josdo/commit-bot/mechanical/Motor v3.SLDPRT

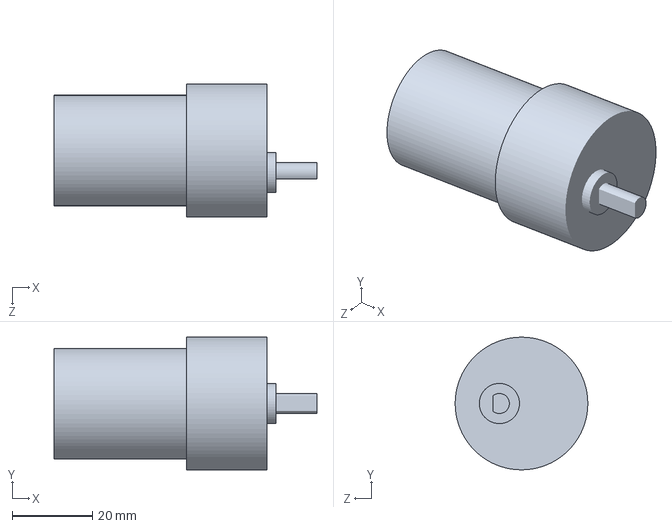
[picture p55: CAD file, 2023-02-14]
mechanical/Motor v3.SLDPRT
65.4 x 33.0 x 33.0 mm
