josdo/commit-bot/(list of files, cad)

Other CAD files:
mechanical/DEV_bottom_board.SLDPRT
mechanical/left_heart.SLDPRT
mechanical/heart.SLDPRT
mechanical/bearing mount.SLDPRT
mechanical/Motor_step.STEP
mechanical/595630 assembly.STEP
mechanical/STLs/DEV_bottom_board.DXF
mechanical/STLs/Encoder_BracketMount.STL
mechanical/STLs/Motor Mount.ipt
mechanical/STLs/Motor Mount.stl
mechanical/STLs/Motor v3.ipt
mechanical/STLs/beacon_sensor.STL
mechanical/STLs/beacon_tower.STL
mechanical/STLs/bearing mount.STL
mechanical/STLs/left_heart.STL
mechanical/STLs/reflectance_holder.STL
mechanical/STLs/reflectance_holder_v1.STL
mechanical/STLs/servo_holder.STL
mechanical/STLs/short_bearing_mount.STL
mechanical/STLs/top_bearing_mount.STL
mechanical/STLs/wall_mount_2.STL
mechanical/motor_Mount.SLDPRT
