josdo/commit-bot/schematics/schematics.pdf

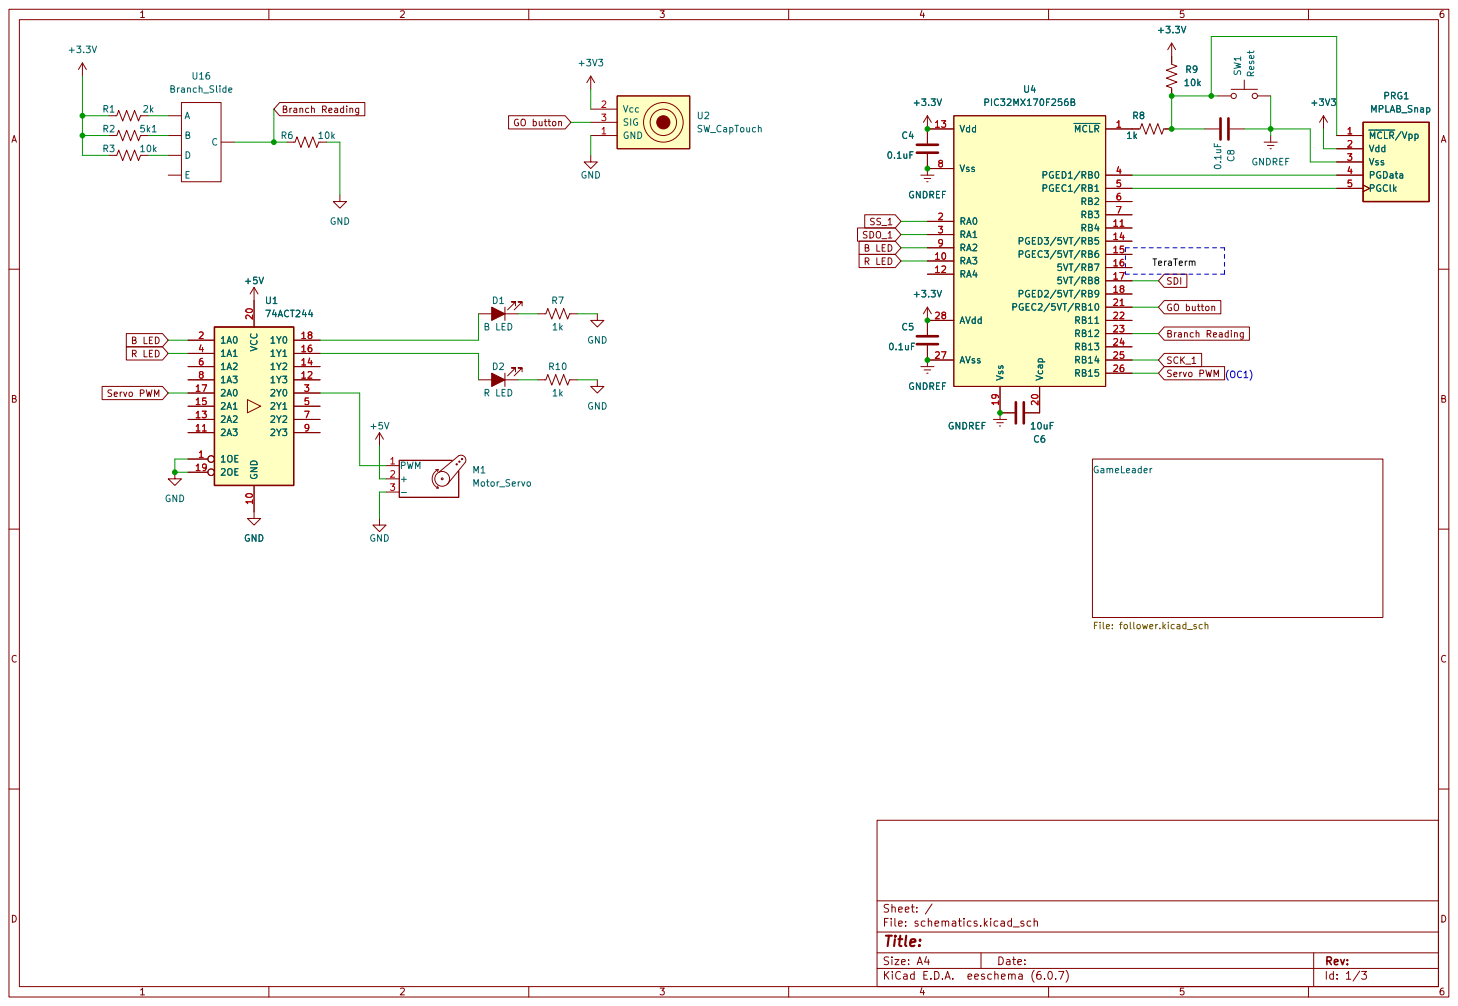
[picture p56: page 1]

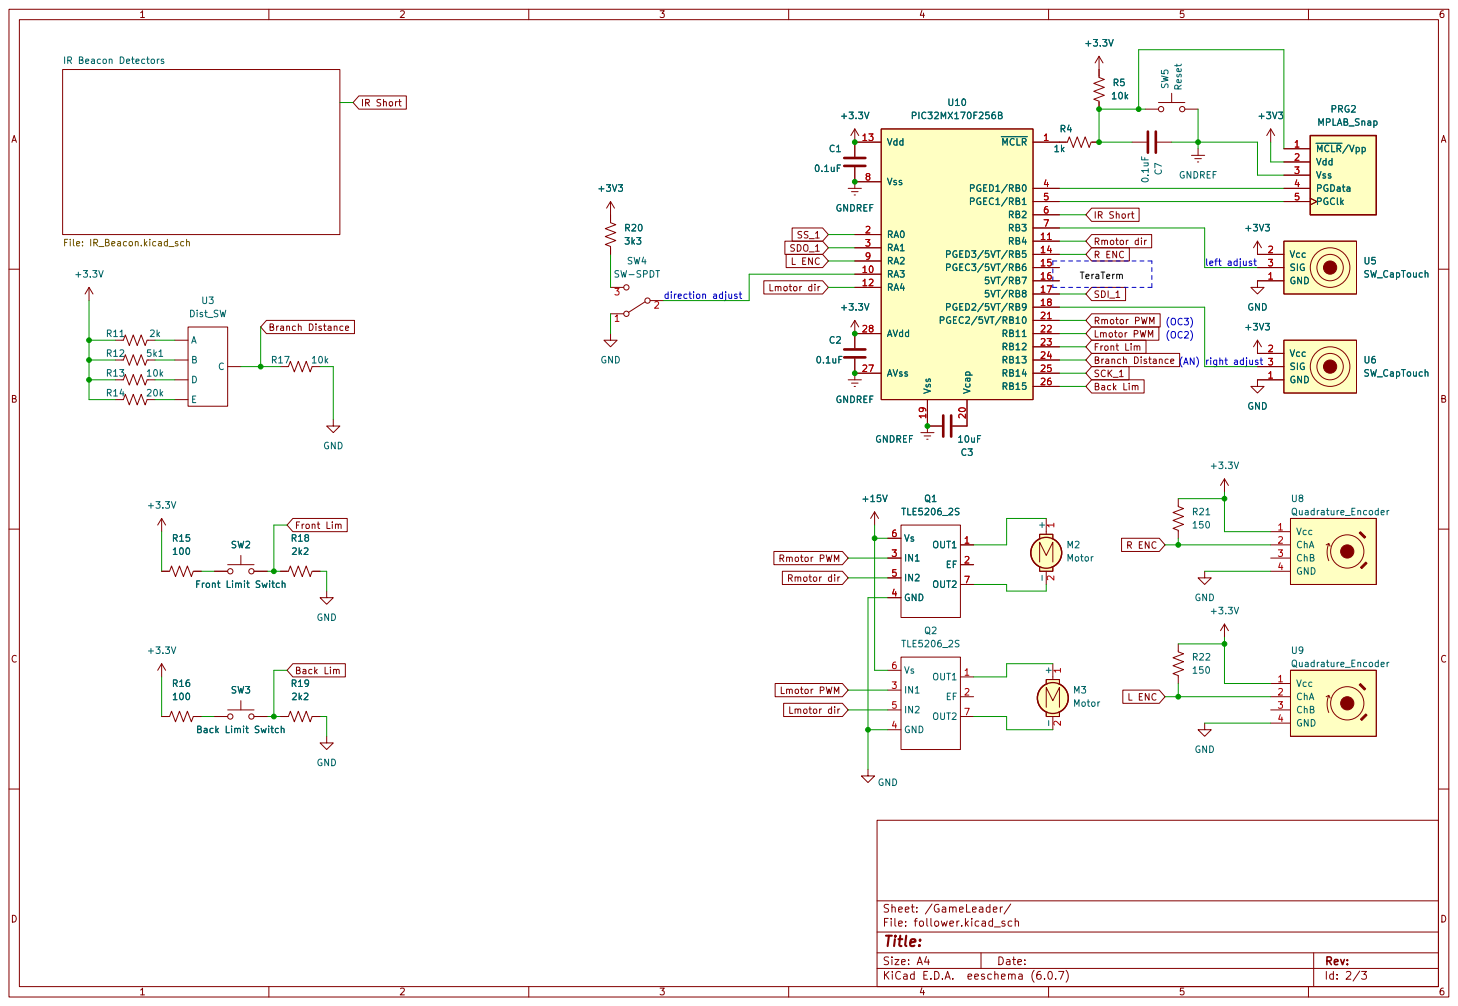
[picture p57: page 2]

IR Short Rmotor dir Back Lim
+3V3 GND

-2 M2 Motor SW2 Front Limit Switch R15
2k2 SW3 Back Limit Switch R16

-2 M3 Motor SW3 Back Limit Switch

File: follower.kicad_sch Sheet: /GameLeader/
Id: 2/3 Title:

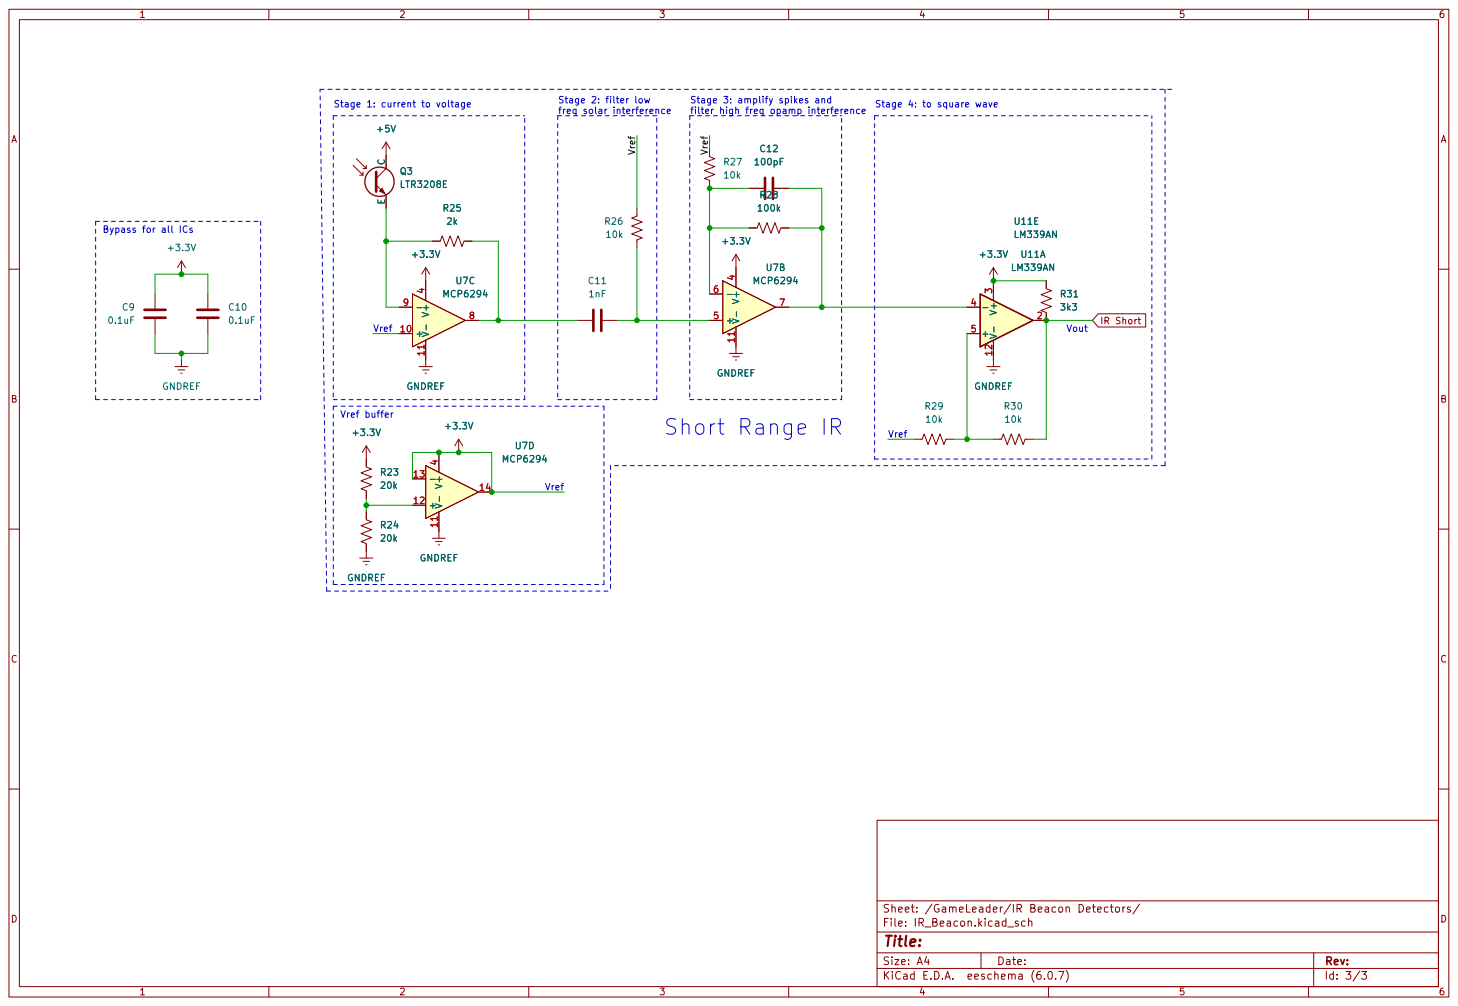
[picture p58: page 3]

Stage 3: amplify spikes and
7 +3.3V GNDREF C12
10k GNDREF

File: IR_Beacon.kicad_sch Sheet: /GameLeader/IR Beacon Detectors/
Id: 3/3 Title:
