josdo/commit-bot/DriveLeader/FrameworkHeaders/ES_Configure.h

/****************************************************************************
 Module
     ES_Configure.h
 Description
     This file contains macro definitions that are edited by the user to
     adapt the Events and Services framework to a particular application.
 Notes

 History
 When           Who     What/Why
 -------------- ---     --------
 12/19/16 20:19  jec     removed EVENT_CHECK_HEADER definition. This goes with
                         the V2.3 move to a single wrapper for event checking
                         headers
  10/11/15 18:00 jec     added new event type ES_SHORT_TIMEOUT
  10/21/13 20:54 jec     lots of added entries to bring the number of timers
                         and services up to 16 each
 08/06/13 14:10 jec      removed PostKeyFunc stuff since we are moving that
                         functionality out of the framework and putting it
                         explicitly into the event checking functions
 01/15/12 10:03 jec      started coding
*****************************************************************************/

#ifndef ES_CONFIGURE_H
#define ES_CONFIGURE_H

#include "../../Shared/ES_Shared_Configure.h"

// #define DEBUG_ON

/****************************************************************************/
// The maximum number of services sets an upper bound on the number of
// services that the framework will handle. Reasonable values are 8 and 16
// corresponding to an 8-bit(uint8_t) and 16-bit(uint16_t) Ready variable size
#define MAX_NUM_SERVICES 16

/****************************************************************************/
// This macro determines that nuber of services that are *actually* used in
// a particular application. It will vary in value from 1 to MAX_NUM_SERVICES
#define NUM_SERVICES 2

/****************************************************************************/
// These are the definitions for Service 0, the lowest priority service.
// Every Events and Services application must have a Service 0. Further
// services are added in numeric sequence (1,2,3,...) with increasing
// priorities
// the header file with the public function prototypes

#define SERV_0_HEADER "TestHarnessService0.h"
// the name of the Init function
#define SERV_0_INIT InitTestHarnessService0
// the name of the run function
#define SERV_0_RUN RunTestHarnessService0
// How big should this services Queue be?
#define SERV_0_QUEUE_SIZE 5

/****************************************************************************/
// The following sections are used to define the parameters for each of the
// services. You only need to fill out as many as the number of services
// defined by NUM_SERVICES
/****************************************************************************/
// These are the definitions for Service 1
#if NUM_SERVICES > 1
// the header file with the public function prototypes
#define SERV_1_HEADER "TopHSM.h"
// the name of the Init function
#define SERV_1_INIT InitTopHSM
// the name of the run function
#define SERV_1_RUN RunTopHSM
// How big should this services Queue be?
#define SERV_1_QUEUE_SIZE 4
#endif

/****************************************************************************/
// These are the definitions for Service 2
#if NUM_SERVICES > 2
// the header file with the public function prototypes
#define SERV_2_HEADER "OptoSensorService.h"
// the name of the Init function
#define SERV_2_INIT InitOptoSensorService
// the name of the run function
#define SERV_2_RUN RunOptoSensorService
// How big should this services Queue be?
#define SERV_2_QUEUE_SIZE 3
#endif

/****************************************************************************/
// These are the definitions for Service 3
#if NUM_SERVICES > 3
// the header file with the public function prototypes
#define SERV_3_HEADER "DisplayEncoderService.h"
// the name of the Init function
#define SERV_3_INIT InitDisplayEncoderService
// the name of the run function
#define SERV_3_RUN RunDisplayEncoderService
// How big should this services Queue be?
#define SERV_3_QUEUE_SIZE 3
#endif

/****************************************************************************/
// These are the definitions for Service 4
#if NUM_SERVICES > 4
// the header file with the public function prototypes
#define SERV_4_HEADER "TestHarnessService4.h"
// the name of the Init function
#define SERV_4_INIT InitTestHarnessService4
// the name of the run function
#define SERV_4_RUN RunTestHarnessService4
// How big should this services Queue be?
#define SERV_4_QUEUE_SIZE 3
#endif

/****************************************************************************/
// These are the definitions for Service 5
#if NUM_SERVICES > 5
// the header file with the public function prototypes
#define SERV_5_HEADER "TestHarnessService5.h"
// the name of the Init function
#define SERV_5_INIT InitTestHarnessService5
// the name of the run function
#define SERV_5_RUN RunTestHarnessService5
// How big should this services Queue be?
#define SERV_5_QUEUE_SIZE 3
#endif

/****************************************************************************/
// These are the definitions for Service 6
#if NUM_SERVICES > 6
// the header file with the public function prototypes
#define SERV_6_HEADER "TestHarnessService6.h"
// the name of the Init function
#define SERV_6_INIT InitTestHarnessService6
// the name of the run function
#define SERV_6_RUN RunTestHarnessService6
// How big should this services Queue be?
#define SERV_6_QUEUE_SIZE 3
#endif

/****************************************************************************/
// These are the definitions for Service 7
#if NUM_SERVICES > 7
// the header file with the public function prototypes
#define SERV_7_HEADER "TestHarnessService7.h"
// the name of the Init function
#define SERV_7_INIT InitTestHarnessService7
// the name of the run function
#define SERV_7_RUN RunTestHarnessService7
// How big should this services Queue be?
#define SERV_7_QUEUE_SIZE 3
#endif

/****************************************************************************/
// These are the definitions for Service 8
#if NUM_SERVICES > 8
// the header file with the public function prototypes
#define SERV_8_HEADER "TestHarnessService8.h"
// the name of the Init function
#define SERV_8_INIT InitTestHarnessService8
// the name of the run function
#define SERV_8_RUN RunTestHarnessService8
// How big should this services Queue be?
#define SERV_8_QUEUE_SIZE 3
#endif

/****************************************************************************/
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
#endif
#if NUM_DIST_LISTS > 4
#define DIST_LIST4 PostTemplateFSM
#endif
#if NUM_DIST_LISTS > 5
#define DIST_LIST5 PostTemplateFSM
#endif
#if NUM_DIST_LISTS > 6
#define DIST_LIST6 PostTemplateFSM
#endif
#if NUM_DIST_LISTS > 7
#define DIST_LIST7 PostTemplateFSM
#endif

/****************************************************************************/
// This is the list of event checking functions
#define EVENT_CHECK_LIST Check4Keystroke, Check4CornerBeacons, Check4FirstBranch, Check4ThirdBranch, \
                         Check4InitialDistance, reachedDesiredLPulses, reachedDesiredRPulses, \
                         reachedBothDesiredPulses, Check4Wall, check4GameTimer, \
                         pressedLeftAdjust, pressedRightAdjust

/****************************************************************************/
// These are the definitions for the post functions to be executed when the
// corresponding timer expires. All 16 must be defined. If you are not using
// a timer, then you should use TIMER_UNUSED
// Unlike services, any combination of timers may be used and there is no
// priority in servicing them
#define TIMER_UNUSED ((pPostFunc)0)
#define TIMER0_RESP_FUNC PostTestHarnessService0
#define TIMER1_RESP_FUNC PostTopHSM
#define TIMER2_RESP_FUNC PostTopHSM
#define TIMER3_RESP_FUNC TIMER_UNUSED
#define TIMER4_RESP_FUNC TIMER_UNUSED
#define TIMER5_RESP_FUNC TIMER_UNUSED
#define TIMER6_RESP_FUNC TIMER_UNUSED
#define TIMER7_RESP_FUNC PostTopHSM
#define TIMER8_RESP_FUNC TIMER_UNUSED
#define TIMER9_RESP_FUNC PostTestHarnessService0
#define TIMER10_RESP_FUNC PostTestHarnessService0
#define TIMER11_RESP_FUNC PostTestHarnessService0
#define TIMER12_RESP_FUNC PostTopHSM
#define TIMER13_RESP_FUNC PostTopHSM
#define TIMER14_RESP_FUNC PostTopHSM
#define TIMER15_RESP_FUNC PostTestHarnessService0

/****************************************************************************/
// Give the timer numbers symbolc names to make it easier to move them
// to different timers if the need arises. Keep these definitions close to the
// definitions for the response functions to make it easier to check that
// the timer number matches where the timer event will be routed
// These symbolic names should be changed to be relevant to your application

#define FREQ_TIMER 0
#define QUERY_TIMER 1
#define TURN_90_TIMER 2
#define SERVICE0_TIMER 15
#define T_KEY_TIMER 9
#define PRINT_ENCODER_TIMER 10
#define PRINT_MOTOR_TIMER 11
#define STOP_TIMER 14
#define QUERY_FOLLOWER_TIMER 12
#define FAST_RATE_TIMER 13
#define COME_BACK_STOP_TIMER 7
//#define TURN_TIMER 0
//#define PERIOD_TIMER 1
//#define COMMAND_TIMER 14
//#define OPTO_READ_TIMER 15
//#define NEXT_STEP_TIMER 0
//#define DIAL_READ_TIMER 1
//#define NEXT_DISPLAY_TIMER 2


#endif /* ES_CONFIGURE_H */
