josdo/commit-bot/DriveLeader/FrameworkHeaders/BeaconSensor.h

#ifndef BeaconSensor_H
#define BeaconSensor_H

#include "ES_Types.h"

void InitBeaconSensor();

typedef enum {
    ShortRangeBeaconSensor = 0,        
    LongRangeBeaconSensor
}BeaconSensor_t;

typedef enum {
    NoBeacon = 0,
    BeaconA,
    BeaconB,
    BeaconC,
    BeaconD
}WhichBeacon_t;

WhichBeacon_t getBeaconName(BeaconSensor_t);
uint32_t getBeconSensorPeriod(BeaconSensor_t);

#endif
