josdo/commit-bot/DriveLeader/ProjectHeaders/PushCommitSM.h

#ifndef PushCommitSM_H
#define PushCommitSM_H

typedef enum {
    BACK_UP_A_BIT,
    FORWARD_A_BIT,
    ROTATE_TO_FACE_BRANCH,
    FORWARD1,
    FORWARD2,
    FORWARDLAST
} PushCommitSMState_t;

ES_Event_t RunPushCommitSM(ES_Event_t CurrentEvent);
void StartPushCommitSM(ES_Event_t CurrentEvent);
PushCommitSMState_t QueryPushCommitSM(void);

#endif
