josdo/commit-bot/DriveLeader/FrameworkHeaders/AdjustButtons.h

#include "ES_Configure.h"
#include "ES_Framework.h"
#include "DCMotor.h"

void InitAdjustButtons(void);
Directions_t getAdjustDirection(void);
bool pressedLeftAdjust(void);
bool pressedRightAdjust(void);
