josdo/commit-bot/DriveLeader/ProjectHeaders/EventCheckWrapper.h

/****************************************************************************
 Module
     ES_EventCheckWrapper.h
 Description
     This is a wrapper header file for all of the header files that include
     prototypes for event checking functions.
 Notes

 History
 When           Who     What/Why
 -------------- ---     --------
 12/19/16 20:12 jec      Started coding
*****************************************************************************/

#ifndef ES_EventCheckWrapper_H
#define ES_EventCheckWrapper_H

// This is the header for the event checkers for the template project
#include "EventCheckers.h"
#include "OptoSensorService.h"
#include "ButtonService.h"
#include "CalibrationSM.h"
#include "GoToBranchOriginSM.h"
#include "DCMotor.h"
#include "ComeBackSM.h"
#include "Timer5.h"
#include "AdjustButtons.h"

//#include "MotorStepService.h"

// Here you would #include the header files for any other modules that
// contained event checking functions

#endif  // ES_EventCheckWrapper_H
