josdo/commit-bot/DriveLeader/ProjectSource/TestHarnessService0.c

#include "ES_Configure.h"
#include "ES_Framework.h"
#include "DistanceSensor.h"
#include "TapeSensor.h"
#include "ES_Port.h"
#include "terminal.h"
#include "dbprintf.h"
#include "PWM_PIC32.h"
#include "PIC32PortHAL.h"
#include "PIC32_AD_Lib.h"
#include <xc.h>            
#include <sys/attribs.h>
#include "TestHarnessService0.h"
#include "BeaconSensor.h"
#include "DCMotor.h"
#include "InitTimer2.h"
#include "DistanceSlider.h"
#include <math.h>


/*----------------------------- Module Defines ----------------------------*/
// these times assume a 10.000mS/tick timing
#define ONE_SEC 1000
#define HALF_SEC (ONE_SEC / 2)
#define TWO_SEC (ONE_SEC * 2)
#define FIVE_SEC (ONE_SEC * 5)

/*---------------------------- Module Variables ---------------------------*/
// with the introduction of Gen2, we need a module level Priority variable
static uint8_t MyPriority;

bool InitTestHarnessService0(uint8_t Priority)
{
  clrScrn();
  ES_Event_t ThisEvent;

  MyPriority = Priority;

  // initialising everything
  InitTimer2();
  InitDistanceSlider();
  InitBeaconSensor();
  InitDCMotor(true);
  DB_printf("Initialized TestHarnessService0, compiled at %s on %s\r\n", __TIME__, __DATE__);
  
  ThisEvent.EventType = ES_INIT;
  if (ES_PostToService(MyPriority, ThisEvent) == true)
  {
    return true;
  }
  else
  {
    return false;
  }
}


bool PostTestHarnessService0(ES_Event_t ThisEvent)
{
  return ES_PostToService(MyPriority, ThisEvent);
}


ES_Event_t RunTestHarnessService0(ES_Event_t ThisEvent)
{
  static uint32_t dc = 0;
  static uint32_t desired_speed = 0;
  static uint32_t desired_direction = FORWARD;
  static bool print_motor_metrics = false;
  static bool pi_control_on = true;
  static bool t_key_go_forward = true;
  static const uint16_t t_key_forward_time = 5000;
  static const uint16_t t_key_backward_time = 2000;
  static const uint32_t t_key_dc = 100;
  static uint16_t motor_timer_period = 100;
  static uint32_t last_rt = 0;
  static uint16_t encoder_timer_period = 400;
  static uint32_t n_key_cm = 5;

  ES_Event_t ReturnEvent;
  ReturnEvent.EventType = ES_NO_EVENT; // assume no errors

  switch (ThisEvent.EventType)
  {
    case ES_INIT:
    {
        DB_printf("\rES_INIT received in Test Service %d\r\n", MyPriority);
        ES_Timer_InitTimer(SERVICE0_TIMER, HALF_SEC);
    }
    break;
    
    case ES_TIMEOUT:
    {
        if(ThisEvent.EventParam == SERVICE0_TIMER){
            // DB_printf("Distance Slider Value: %d\r\n", getDesiredBranchDistance());
//           DB_printf("Distance Period is: %d\r\n", getDistance());
//            DB_printf("Middle Is it on tape: %d\r\n", isOnTape(MiddleTapeSensor));
//            DB_printf("Middle Is it on tape: %d\r\n", isOnTape(MiddleTapeSensor));
//            DB_printf("Middle Is it on tape: %d\r\n", getTapeValue(MiddleTapeSensor));
//            DB_printf("Short Range Period: %d\r\n", getBeconSensorPeriod(ShortRangeBeaconSensor));
            ES_Timer_InitTimer(SERVICE0_TIMER, HALF_SEC);
        }
        else if (ThisEvent.EventParam == PRINT_MOTOR_TIMER)
        {
          float rspeed = getMotorSpeed(RIGHT_MOTOR);
          float lspeed = getMotorSpeed(LEFT_MOTOR);
          DB_printf("Rspeed %d  Lspeed %d  Diff %d\r\n", (uint32_t)rspeed, (uint32_t)lspeed, abs(rspeed - lspeed));
          ES_Timer_InitTimer(PRINT_MOTOR_TIMER, motor_timer_period);
        }
        else if (ThisEvent.EventParam == PRINT_ENCODER_TIMER)
        {
          uint32_t rt = getRolloverTicks();
          DB_printf("Rollover ms %u\r\n", rt * 200 / 1000 / 1000);
          // DB_printf("Rollover delta ms %d\r\n", (rt - last_rt) * 200 / 1000 / 1000);
          last_rt = rt;
          ES_Timer_InitTimer(PRINT_ENCODER_TIMER, encoder_timer_period);
        }
        else if (ThisEvent.EventParam == T_KEY_TIMER)
        {
          // If finished going forward for T_KEY_TIMER, then go backwards for T_KEY_TIMER
          if (!t_key_go_forward)
          {
            DB_printf("Going backward for %u ms\r\n", t_key_backward_time);
            t_key_go_forward = true;
            ES_Timer_InitTimer(T_KEY_TIMER, t_key_backward_time);
            setMotorSpeed(RIGHT_MOTOR, BACKWARD, t_key_dc);
            setMotorSpeed(LEFT_MOTOR, BACKWARD, t_key_dc);
          }
          // If finished going backwards, stop.
          else
          {
            DB_printf("Finished t_key test sequence\r\n");
            setMotorSpeed(RIGHT_MOTOR, FORWARD, 0);
            setMotorSpeed(LEFT_MOTOR, FORWARD, 0);
          }
        }
    }
    break;

    case ES_NEW_KEY:
    {
      DB_printf("Key -> %c <- pressed\r\n", ThisEvent.EventParam);

      /* Set duty cycle. */
      if ('k' == ThisEvent.EventParam)
      {
        dc = dc == 100 ? 100 : dc + 10;
        setMotorSpeed(RIGHT_MOTOR, desired_direction, dc);
        setMotorSpeed(LEFT_MOTOR, desired_direction, dc);
        DB_printf("Increase PWM to %u\r\n", dc);
      }
      else if ('j' == ThisEvent.EventParam)
      {
        dc = dc == 0 ? 0 : dc - 10;
        setMotorSpeed(RIGHT_MOTOR, desired_direction, dc);
        setMotorSpeed(LEFT_MOTOR, desired_direction, dc);
        DB_printf("Decrease PWM to %u\r\n", dc);
      }

      /* Set desired speed. */
      else if ('o' == ThisEvent.EventParam)
      {
        // Turn off PI control if currently on.
        if (pi_control_on)
        {
          pi_control_on = false;
          disablePIControl();
          DB_printf("Turned off PI control\r\n");
        }
        else
        {
          pi_control_on = true;
          enablePIControl();
          DB_printf("Turned on PI control\r\n");
        }
      }
      else if ('i' == ThisEvent.EventParam)
      {
        // desired_speed = desired_speed == 100 ? 100 : desired_speed + 10;
          // Increase
          desired_speed += 10;
          setDesiredSpeed(LEFT_MOTOR, desired_direction, desired_speed);
          setDesiredSpeed(RIGHT_MOTOR, desired_direction, desired_speed);
          DB_printf("Increase desired speed to %u\r\n", desired_speed);
      }
      else if ('u' == ThisEvent.EventParam)
      {
          // Decrease

          desired_speed = desired_speed == 0 ? 0 : desired_speed - 10;
          setDesiredSpeed(LEFT_MOTOR, desired_direction, desired_speed);
          setDesiredSpeed(RIGHT_MOTOR, desired_direction, desired_speed);
          DB_printf("Decrease desired speed to %u\r\n", desired_speed);
      }

      /* Print motor metrics. */
      else if ('m' == ThisEvent.EventParam)
      {
        if (print_motor_metrics)
        {
          print_motor_metrics = false;
          ES_Timer_StopTimer(PRINT_MOTOR_TIMER);
          // ES_Timer_StopTimer(PRINT_ENCODER_TIMER);
          DB_printf("Stopped printing motor metrics\r\n");
        }
        else
        {
          print_motor_metrics = true;
          ES_Timer_InitTimer(PRINT_MOTOR_TIMER, motor_timer_period);
          // ES_Timer_InitTimer(PRINT_ENCODER_TIMER, encoder_timer_period);
          DB_printf("Start printing motor metrics\r\n");
        }
      }

      else if ('t' == ThisEvent.EventParam)
      {
        // Go forward at 50 duty cycle for 5 seconds.
        if (t_key_go_forward == true)
        {
          DB_printf("Going forward for %u ms\r\n", t_key_forward_time);
          t_key_go_forward = false;
          ES_Timer_InitTimer(T_KEY_TIMER, t_key_forward_time);
          setMotorSpeed(RIGHT_MOTOR, FORWARD, t_key_dc);
          setMotorSpeed(LEFT_MOTOR, FORWARD, t_key_dc);
        }
      }
      else if ('l' == ThisEvent.EventParam)
      {
        if (desired_direction == FORWARD)
        {
          desired_direction = BACKWARD;
          // setMotorSpeed(RIGHT_MOTOR, desired_direction, dc);
          // setMotorSpeed(LEFT_MOTOR, desired_direction, dc);
          setDesiredSpeed(LEFT_MOTOR, desired_direction, desired_speed);
          setDesiredSpeed(RIGHT_MOTOR, desired_direction, desired_speed);
          DB_printf("Drive backwards\r\n");
        }
        else
        {
          desired_direction = FORWARD;
          // setMotorSpeed(RIGHT_MOTOR, desired_direction, dc);
          // setMotorSpeed(LEFT_MOTOR, desired_direction, dc);
          setDesiredSpeed(LEFT_MOTOR, desired_direction, desired_speed);
          setDesiredSpeed(RIGHT_MOTOR, desired_direction, desired_speed);
          DB_printf("Drive forward\r\n");
        }
      }

      else if ('r' == ThisEvent.EventParam)
      {
        DB_printf("Rotate CW\r\n");
        rotate90(CW, 60);
      }

      else if ('n' == ThisEvent.EventParam)
      {
        DB_printf("Drive %u cm forwards\r\n", n_key_cm);
        drive(FORWARD, n_key_cm, 20);
      }
      else if ('b' == ThisEvent.EventParam)
      {
        DB_printf("Drive %u cm backwards\r\n", n_key_cm);
        drive(BACKWARD, n_key_cm, 20);
      }
      
    }
  }

  return ReturnEvent;
}
