josdo/commit-bot/(commit log)

2022-11-13 Upload circuits with 10uF piezo cap
    [Project_Audio.kicad_sch, Project_Schematic1.kicad_pcb, Project_Schematic1.kicad_sch]
2022-11-13 Ignore kicad pdfs since easily outdated
2022-11-13 Fix kicad label
    [Project_Schematic1.kicad_sch]
2022-11-13 Add AD and PWM libraries from Ed
2022-11-14 Print drum piezo reading (untested)
2022-11-15 Move AD_lib files into Framework dirs
2022-11-15 Rename Controller file + Tell framework this service exists
2022-11-15 Fix no tera term printing
    * Due to event checker always returning true, and no posting to services, so continuing in event checker loop and never initializing services
2022-11-16 Add welcome state LEDs, IR game start, and interaction timer
2022-11-17 Add servo responding to correct hits
    [ES_Configure.h]
2022-11-17 Use parallel diode with voltage reference to make up for -600mV diode forward voltage
    [Project_Schematic1.kicad_sch]
2022-11-17 Add second timer LED strip
2022-11-17 Redo piezo circuit with diode in serial to pin
    [Project_Schematic1.kicad_sch]
2022-11-17 Read piezo from left drum and reset below a threshold (tested)
    [ES_Configure.h]
2022-11-17 Refactor LED strip and implement game timer
2022-11-17 Ignore analog below min piezo (10) + Print intensities
    * Should we continually send 0s, spamming the intensity service?
2022-11-17 Change SPI clock speed and start button checker
2022-11-17 Change clock speed and write button function header
2022-11-18 MUX to each drum LED strip and clock + Remove intensity strip
    [Project_Schematic1.kicad_sch]
2022-11-21 Choose custom resistors to constrain piezo voltage below 3.3V
    * Rarely exceeds, but especially bottom drum does, so maybe add unity gain buffer
    [Project_Schematic1.kicad_sch]
2022-11-21 Press button to cycle between minimum piezo thresholds
    [Project_Schematic1.kicad_sch]
2022-11-22 Clip piezo signal at 3.3V + Increase sensitivity with resistors on L, B drums
    [Project_Schematic1.kicad_sch]
2022-11-23 Update schematic with new pins
    [Project_Schematic1.kicad_sch]
2022-11-23 Fix skipping first note + Register correct drum hit in ControllerFSM + Refactor
    [ES_Configure.h]
2022-11-23 Brighten drums with hit intensity + Add LED enum for No Drums
2022-11-23 Add vibration motor and green clock on correct drum hit
    [ES_Configure.h]
2022-11-23 Put motor timer on correct timer number
    [ES_Configure.h]
2022-11-26 Merge branch 'master' of https://bitbucket.org/joshuadong/drumhero
    # Conflicts:
    # FrameworkHeaders/ES_Configure.h
2022-11-26 Button press for toggling the vibration motor works. Now we have three inputs.
2022-11-27 Update servo service to move servo every 2 hits
2022-11-27 Update KiCad with motor button and new pins for MUX sel0 and audio PWM
    [Project_Schematic1.kicad_sch]
2022-11-28 Program the song for the zen mode. Fix the led lighting up issue on the first hit. make the drum hits randomised.
    [ES_Configure.h]
2022-11-28 Update audio kicad
    [Project_Audio.kicad_sch]
2022-11-28 Update clock bar time between LED lighting with more notes
2022-11-29 Change timer color to gold on correct hit
2022-11-29 Change IR covered to one second and have clock LEDs fade
2022-11-30 Made timer LED strip 13 long
2022-11-30 Increase clock brightness and change Zen mode PWM val
2022-11-30 Change zen pwm duty cycle back to original 30 after debugging
2022-11-30 Adjust the pwm signals for communication.
2022-12-05 Add bypass caps and update piezo resistor values in Kicad
    [Project_Schematic1.kicad_sch]
2022-12-06 Add the values of resistance and capacitance in low pass filter.
    [Project_Audio.kicad_sch]
2022-12-06 Make pdf of the audio pic kicad
2022-12-07 Add solidworks cad files
    [Bottom_Acrylic.SLDPRT, Drum_Hero_Assem.SLDASM, Side_Piece_Long.SLDPRT, Side_Piece_Short.SLDPRT, Side_Piece_Short_Back.SLDPRT, Top_Acrylic.SLDPRT]
2023-01-13 Revert to 3d98758
    [Bottom_Acrylic.SLDPRT, Drum_Hero_Assem.SLDASM, Project_Audio.kicad_sch, Project_Schematic1.kicad_sch, Side_Piece_Long.SLDPRT, Side_Piece_Short.SLDPRT, Side_Piece_Short_Back.SLDPRT, Top_Acrylic.SLDPRT]
2023-01-13 TEMPLATE REPO
    [Project_Audio.kicad_sch, Project_Schematic1.kicad_pcb, Project_Schematic1.kicad_sch]
2023-01-15 Upload circuit schematics
    [circuits.kicad_sch]
2023-01-17 Create MotorStepService and PhaseControl module (untested)
2023-01-17 Compile MotorStepService and PhaseControl
2023-01-18 Fix cap on circuit schematic
    [circuits.kicad_sch]
2023-01-19 Update phase control pins to valid channel pins in schematic
    [circuits.kicad_sch]
2023-01-19 Comment out PWM setup to latch to phase control pins
2023-01-19 Select active channel correctly (still no PWM output)
    * IsForward fn had argument phase_t instead of phaseV_t, so the argument
    kept casting to 1
2023-01-20 [STABLE] Make one phase on work
    * Switched timers for PWM to work
    * Put LED and current limiting resistor in parallel to each coil, allowing full
    3.3V
    across the coil
    [circuits.kicad_sch]
2023-01-20 Change rotation direction with button
    [circuits.kicad_sch]
2023-01-20 Create speed dial service (failing to read dial)
    [circuits.kicad_sch]
2023-01-21 Convert dial readings to speed successfully
    * 0 speed was due to default maxStepRate of 0, which was a todo
    in the motor step service but not configured
2023-01-21 Handle <1 step rate from speed dial
    * Bug froze program at current step since < 1 step rate divided
    1000 into a huge number when
    rounded to uint16_t
2023-01-22 Modify lab 5 schematic for DC motor and nicer looks
    [circuits.kicad_sch]
2023-01-29 PWM at 200Hz from pin A0
    * Comment out most of MotorStepService
    * Disable PhaseControl in MPLAB project
2023-01-29 Set duty cycle in PWM module from speed dial reading in Speed Dial Service
    * TODO: configure A1 pin to digital output low, currently high
2023-01-29 [stable] Run motor with non-PWM inductor terminal low
    * Part 1 complete.
2023-01-30 Label IC/OC pins in schematic
    [circuits.kicad_sch]
2023-01-30 Measure and print out encoder hi pulse (untested)
    * Created Measure.c and DisplayEncoderService.c
2023-01-30 Measure and print encoder period successfully
    * Set output mapping instead of input mapping register
    * Initialize correct period register
    * Use 1:1 prescaling
    * Increment rollover count only when lastEdge.LSB is before halfway
    point to rollover
    TODO
    * Why do I get period + 2^16 every so often? Seems linked to
    updating rollover counter when it shouldn't be in the IC2 ISR
2023-01-30 Add 8 bar LED control to schematic
    [circuits.kicad_sch]
2023-01-30 [stable] Measure and print consistent encoder periods
    * Resolved 2^16 jumps in encoder period values
    * Issue was configuring IC to PWM OC's timer 3, instead of timer 2
    * Both have very close PRs (50k vs 65k), so still kind of worked
2023-01-30 Include 218 baselib in kicad directory
    * Also added 744 cap
    * Finish 744 to LED bars wiring
    * Configure and map PIC32 pins to bar positions
    * Light up bars by encoder bin
    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
    [circuits.kicad_sch]
2023-01-31 Light up more LED bars with longer periods
    [circuits.kicad_sch]
2023-01-31 Calculate and print RPM
    [circuits.kicad_sch]
2023-02-01 Set PWM duty cycle via keypress and change PWM period
2023-02-01 Update schematic to measure motor time constant
    * Rewire circuit for 7.1 + remove bi LED (unwanted extra resistance)
    * Measure ext and int resistors and update schematic
    * Connect probe 1 to PWM and probe 2 to ext resistor
    * Measure rise time
    * Do design calculations for suitable components
    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
    [circuits.kicad_sch]
2023-02-04 [stable] Set period < electrical time constant
    * Motor rise time without external resistance: 198us
    * Set period to 25us
    * Mapped dc to rpm
    [circuits.kicad_sch]
2023-02-04 Set up timer interrupt to update velocity control
    * Using timer 4, every 2ms, prescale 1:1
2023-02-04 [stable] Control rpm velocity with PI
    * Prints out velocity control stats every 60 ms
    * Updates PI control every 20 ms
    * Measure module now says RPM = 0 until after
    seeing a couple initialization edges (without this,
    had ruinous error initially)
    * Set desired RPM velocity with key press or speed dial
    (must set bool in RunMotorSpeedService function)
2023-02-04 Profile time taken in velocity controller update ISR
    * 40us per interrupt, which happens every 2ms,
    so 2% of total execution time
2023-02-06 [stable] Create IR signal conditioning schematic
    * Setup clean repo for lab 8
    [circuits.kicad_sch, lab8.kicad_pcb, lab8.kicad_sch]
2023-02-06 Make SD input function in SPI hal and set up the basic config and pins.
2023-02-06 Annotate IR receiver schematic
    [lab8.kicad_sch]
2023-02-07 interrupts for the reciever not working
    [ES_Configure.h, LeaderService.c, LeaderService.h]
2023-02-07 Fix SPI receive message interrupt and ISR
    [LeaderService.c]
2023-02-07 Add motors and set optical sensor pin in KiCad
    [lab8.kicad_sch]
2023-02-08 Add Motor service to the framework. Add different cases for different commands.
2023-02-08 Finalize IR receiver schematic
    [lab8.kicad_sch]
2023-02-08 Move files to correct directories in MPLAB
    [DCMotorService.c, DCMotorService.h, LeaderService.c, LeaderService.h, PIC32PortHAL.c, PIC32_SPI_HAL.c, PIC32_SPI_HAL.h]
2023-02-08 Add function to handle motor speed and direction
    * function currently not working
    [DCMotorService.c, DCMotorService.h]
2023-02-08 Fix motor speed function
    * used floats for PWM DC calculations
    [DCMotorService.c]
2023-02-08 Make a sevice for opto sensor
2023-02-09 Read analog value from Opto Sensor and print it if its grater than Threshold. Make a button service and start communication if button is pressed.
2023-02-09 Read opto sensor only when "Tape" command is sent to the PIC
    * DCMotorService posts ES_READ_OPTO when "Tape" command given
    * Opto service stops reading opto sensor once tape threshold is met
2023-02-09 Start communicating with command generator with button press
    * SPI communication with command generator not working right now
    [ButtonService.c, DCMotorService.c, DCMotorService.h, ES_Configure.h, EventCheckWrapper.h]
2023-02-09 Fix Send8Wait() command in SPI HAL
    * Can now communicate with the command generator
    [LeaderService.c, OptoSensorService.c, PIC32_SPI_HAL.c]
2023-02-09 Set the correct threshold for the opto sensor.
    [OptoSensorService.c]
2023-02-09 include SPI lines in kicad.
    [lab8.kicad_sch]
2023-02-09 Write ISR for beacon sensor
    * Does not work at the moment
    [DCMotorService.c]
2023-02-09 Fix beacon alignment ISR
    * Was not calling the init function
    [DCMotorService.c, ES_Configure.h]
2023-02-09 Increase gain in first stage opamp
    * Can now detect beacon from end of field, originally could only 2/3 way
    [lab8.kicad_sch]
2023-02-10 Tune motor speed and time with new Al rod skidder
    * Good turns and forward / backwards
    * Fails to move forward on tape command
    [DCMotorService.c]
2023-02-10 Tune forward / reverse speeds for test
    * Slight drift if run a handful of times, likely due to mechanically not rigid
    [DCMotorService.c]
2023-02-14 Rename schematics file
    [schematics.kicad_pcb, schematics.kicad_sch]
2023-02-14 Add motor STL
    [Motor v3.stl, schematics.kicad_sch]
2023-02-14 Make reflectance sensor CAD
    [Reflectance_Sensor.SLDPRT]
2023-02-14 Convert STL to SLDPRT file
    [Motor v3.SLDPRT]
2023-02-14 Start on preliminary CAD for the DEV
    * Base plate with holes for casters and tape sensor
    * Tape sensor holder with bolt holes
    * Tape sensor CAD
    [DEV_bottom_board.SLDPRT, Reflectance_Sensor.SLDPRT, pololu-ball-caster-with-0-750in-metal-ball.step, reflect_assem.SLDASM, reflectance_holder.SLDPRT, reflectance_holder.STL, reflectance_holder_v1.STL, total_robot.SLDASM]
2023-02-14 Misc commit from SolidWorks
    [reflect_assem.SLDASM]
2023-02-14 Put STL files in their own folder for organization
    [Motor v3.stl, reflectance_holder.STL, reflectance_holder_v1.STL]
2023-02-14 Export motor to Autodesk Inventor
    [Motor v3.iam, Motor v3.ipt, Motor v3.stl]
2023-02-14 Work on CAD
    * Starting 2 speed transmission
    * Make STL of bottom chassis
    [Motor_step.STEP, drive_shaft.SLDPRT, transmission_assem.SLDASM]
2023-02-14 Update transmission
    [DEV_bottom_board.SLDPRT, gear_coupler.SLDPRT, transmission_assem.SLDASM]
2023-02-15 Model motor mount
    [Mount.ipt]
2023-02-15 Export mount to STL
    [Mount.stl]
2023-02-16 Make new drive train
    [1600-0002-0250.STEP, 3608-0001-0076 assembly.STEP, 595630 assembly.STEP, bearing mount.SLDPRT, coupler.SLDPRT, drive_shaft.SLDPRT, gear_coupler.SLDPRT, reflect_assem.SLDASM]
2023-02-16 Update schematics and add new symbols to KiCAD
    [IR_Beacon.kicad_sch, follower.kicad_sch, schematics.kicad_sch]
2023-02-16 Use 4 position switches to determine branch and how far to drive in KiCAD
    [IR_Beacon.kicad_sch, schematics.kicad_sch]
2023-02-16 Add STL for new reflectance sensor holder
    [reflectance_holder.STL]
2023-02-16 Add STP file for Pololu distance sensor
2023-02-17 Adjust motor mount after testing 1st print
    [Mount.ipt, Mount.stl]
2023-02-17 Match motor mount height to bearing mount height
    [Motor Mount.ipt, Motor Mount.stl, Motor v3.iam, Mount.ipt, Mount.stl]
2023-02-17 Make changes to the chassis CAD
    * holes for wheels and gears
    * slots for mounts
    * holes for standoffs
    * holes for casters
    [DEV_bottom_board.DXF, DEV_bottom_board.SLDPRT, Encoder_BracketMount.STL, Encoder_MagnetMount.STL, bearing mount.SLDPRT, bottom_bearing_tall.STL, motor_Mount.SLDPRT, pololu-ball-caster-with-0-500in-ball.step]
2023-02-17 Create separate Leader and Follower projects and Start event sending over SPI
    * Follower project contains everything from Lab 8
    * Leader project is clean and only contains Follower Event over SPI code
    * Both projects compile cleanly
2023-02-19 Move IR sensors to follower PIC and add missing SPI PICs
    [follower.kicad_sch, schematics.kicad_sch]
2023-02-19 Update CAD with new mount heights
    [Encoder_BracketMount.STL, Encoder_MagnetMount.STL, Motor Mount.SLDPRT, Motor Mount.stl, bearing mount.SLDPRT, bearing mount.STL, short_bearing_mount.STL, top_bearing_mount.SLDPRT]
2023-02-20 SPI sends and no crash when comment out all interrupts
    [DCMotorService.c, ES_Configure.h, EventOverSPI.c, EventOverSPI.h, TestHarnessService0.c]
2023-02-20 Get the distance in mm from the distance sensor.
2023-02-20 Send over SPI works with a ISR and reading the SPIBUF
2023-02-20 Modify encoder bracket
    * Tab goes from the hole to the edge
    [Encoder_BracketMount.STL]
2023-02-20 isOnTape() function to check if any of the tape sensors detects tape. it takes the tape enum and returns a bool.
2023-02-21 Shorten encoder mount by 8 mm
    [Encoder_BracketMount.STL]
2023-02-21 Set up init timer 2 which handles the ISR for timer 2. Distance sensor only measures the distance corresponding to the smaller period. Setup the beacon sensor functions.
2023-02-21 Make getBeaconSensorFreq function which takes the beacon sensor name as input and outputs the corresponding frequency.
2023-02-21 Change master, Implement MapSSInput and SPI query-response
    * Moved SPI to Shared lib
    * Created Shared lib in MPLab project tree
    * Both PICs resetting on every post, suggesting an interupt issue.
    * Diagnose interrupt issue.
    * Disable follower and see if leader still has issue.
    * Copy ISR to separate files.
    * Inspect interrupt bit setting in MapSSInput
    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
    [ButtonService.c, DCMotorService.c, DCMotorService.h, ES_Configure.h, EventCheckWrapper.h, EventCheckers.c, EventCheckers.h]
2023-02-21 Change SPI ISR IPL from 6 to 7 to fix PIC resets
    TODO:
    * Fix infinite interrupt (see oscope)
    * Enable ISR on follower PIC
    [EventOverSPI.c, TestHarnessService0.c]
2023-02-21 Send one command from leader.
    * Identified cause of infinite sending.
    * Identified cause of IPL6 causing PIC reset.
    [EventOverSPI.c]
2023-02-21 Receive and post event in follower.
    * Identify and fix double print -- is it a double post or a double print?
    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
    [EventOverSPI.c, TestHarnessService0.c]
2023-02-22 Fix double interrupt on a single SPI message.
    * Clear flag after reading buffer.
    * Also fixed organization of EventOverSPI library.
    [EventOverSPI.c, EventOverSPI.h, TestHarnessService0.c]
2023-02-22 Post and receive event from follower successfully. Try modifying SPI buffer before sending.
    * Always sends the same NO_LEFTOVER_WORD back.
    * Sometimes sends the correct word, but delayed.
    * Stops responding when set SPI1BUF inside InitEventOverSPI.
    * Understand and debug behavior.
    * After 30 min, implement the NEXT / STOP pumping way.
    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
    [ES_Shared_Configure.h, EventOverSPI.c, EventOverSPI.h, TestHarnessService0.c]
2023-02-22 Make a module level velocity variable and make a setter function for it.
2023-02-22 Gear SolidWorks files
    [IR_Beacon.kicad_sch, follower.kicad_sch, spur_20_D.SLDPRT, spur_40_D.SLDPRT, spur_60_D.SLDPRT]
2023-02-22 Query once from leader and load directly into SPIBUF from follower
    * Got several noisy query words back e.g. 0xAAAE, 0xEEEA, but none
    when jumpers pushed into breadboard more.
    * Per Ed: to guarantee SPIBUF written to, turn off SPI and then turn on -- but this seems
    to allow SPI interrupts to get skipped.
    * Change LEFTOVER_WORD to 0 and check length of ES_EventTypes for invalid event filtering
    * Invalid words to leader -- probably jumper wires bad.
    * Skipping the SPIBUF written word always. Do double query and only
    use queue in follower.
    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
    [ES_Shared_Configure.h, EventOverSPI.c, TestHarnessService0.c]
2023-02-22 Leader can receive 20 queued events from follower.
    * No missed events like before.
    * No sending back QUERY_WORD because follower
    did not have time to update the SPIBUF like before.
    * Stops working when remove printf's from the leader ISR ... so the
    follower is likely still too slow due to the list.
    * Diagnose and stop leader from hanging when it sends to follower
    without printfs.
    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
    [ES_Configure.h, EventOverSPI.c, TestHarnessService0.c]
2023-02-22 [stable] Post from leader to follower and back to leader easily
    * Leader would hang if send16_wait() in ISR without a for loop (2000 iterations) or printf delay.
    Resolved by using send16(), which has no while loop to get stuck in.
    Warning: many back to back transmissions from leader to follower, which we should not encounter.
    * Replaced inefficient shift forward list implementation of the queue
    with a second front index that resets when it reaches the
    same value as queue size.
    * Removed printf's, speeding up ISRs so they don't miss events.
    [EventOverSPI.c]
2023-02-22 Increase SPI CLK from 10 to 50KHz.
    * At 100KHz, the first events from the leader to follower
    when the follower has no queued events returns invaild
    events. (But no more invalids observed afterwards)
    * No observed invalids at 50KHz.
    Warning: this may be a source of bugs with invalids in
    future, so re-run test harness to check.
    [EventOverSPI.c]
2023-02-22 Update pulseview SPI settings
2023-02-23 [stable] Merge DriveMaster changes with working PIC-to-PIC.
    * Compile and testing successful.
    [follower.kicad_sch, schematics.kicad_sch]
2023-02-23 Update mechanical/ with latest from master
    [Encoder_BracketMount.STL, Encoder_MagnetMount.STL, Motor Mount.SLDPRT, Motor Mount.stl, bearing mount.SLDPRT, bearing mount.STL, short_bearing_mount.STL, spur_20_D.SLDPRT]
2023-02-24 Write an HSM with Calibration state machine
2023-02-24 Write a top HSM along with the first state which is the calibration SM. Write a distance sensor library file.
2023-02-24 Choose encoder pins and correct rollover time update.
    [IR_Beacon.kicad_sch, master.kicad_sch, schematics.kicad_sch]
2023-02-25 Calibration SM woorking with timers.
2023-02-26 Implement Calibration State machine with event checkers
2023-02-26 implement Go to branch state machine which has a history variable that takes care of the current branch.
2023-02-26 Add files for branch choosing switch
2023-02-26 Write init function for analog switch pins
    * Working on getter functions
2023-02-26 Update KiCAD schematic and write getter functions for switches
    [IR_Beacon.kicad_sch, schematics.kicad_sch]
2023-02-27 Add SM for reversing out of a branch
    * Reverse until 10 cm away from wall
    * Turn 90 deg CW - based on timer
    [CalibrationSM.c, ComeBackSM.c, ComeBackSM.h, ES_Configure.h, TopHSM.c]
2023-02-27 Adjust speed for turning and backing up during calibration
2023-02-28 implement a stop state in calibration, also start the sm for follow tape.
2023-02-28 Tune checkpoint test forward and reverse times.
    [TestHarnessService0.c]
2023-02-28 Correct encoder pins on KiCad.
    [follower.kicad_sch, schematics.kicad_sch]
2023-02-28 Correctly update rollover time.
    * Enabled interrupts for the Timer 3 vector.
    * Changed getRolloverTime to output us not ticks.
    [DCMotor.c, TestHarnessService0.c]
2023-02-28 Change back to getRolloverTicks for use in encoder ISRs.
    * Test rollover updates correct with wheels spinning.
    * Test input captures correct.
    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
    [DCMotor.c, DCMotor.h, TestHarnessService0.c]
2023-03-01 Use timer 2 (PR 0xFFFF) for encoders instead of timer 3 (PR PWM).
2023-03-01 Use timer 2 (PR 0xFFFF) for encoders instead of timer 3 (PR PWM).
    * At 20% dc, the printed period is a multiple off of oscope period.
2023-03-01 Filter out invalid encoder ISR periods. Prescale T2 to 4 and adjust beacon / distance sensor.
2023-03-02 Change the query timer from follower
2023-03-02 implement event checker for limit switch. Implement logic for going to branch 2 and 3.
2023-03-03 implement the Push Commit state machine. set up the event checkers for limit switches.
2023-03-03 Set up events over spi with HSM
2023-03-04 Fix the Beacon Sensor IC
    [BeaconSensor.c, ES_Shared_Configure.h, GoToBranchOriginSM.c]
2023-03-05 integrate the tape sensor.
2023-03-06 Get rid of GetTime in rear limit switch
2023-03-06 Check 4 tape to come forward in calibration state.
2023-03-06 Fix the limit switch issue
    [BeaconSensor.c, CalibrationSM.c, DCMotor.c, DCMotor.h, DistanceSensor.c, ES_Configure.h, ES_Shared_Configure.h, EventCheckWrapper.h]
2023-03-07 Drive set distance in GoToBranchOrigin. Fix PushCommit not reaching MOVE_FORWARD.
    [GoToBranchOriginSM.c, PushCommitSM.c, PushCommitSM.h, TopHSM.c]
2023-03-07 [stable] Fix many important issues.
    FIXED:
    * Rotation off by 1 tick on 1 wheel.
    * Limit switch event checker never called.
    * Return event in ComeBackSM during function.
    Also
    * Added DEBUG mode for speeds.
    * Created and integrated timer 5.
    * Debug why does not come back after pushing commit in branch 1 a second time.
    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
    [CalibrationSM.c, ComeBackSM.c, DCMotor.c, ES_Configure.h, EventCheckWrapper.h, EventOverSPI.c, GoToBranchOriginSM.c, GoToBranchOriginSM.h]
2023-03-07 Fix limit switch event checker.
    [CalibrationSM.h, ComeBackSM.c, ES_Configure.h, EventCheckers.c, GoToBranchOriginSM.c]
2023-03-07 [stable] Fix event checker for third branch. All logic works on test harness.
    [GoToBranchOriginSM.c]
2023-03-07 Clear PI error history every setDesiredSpeed to eliminate jerk of left motor from rest.
    [DCMotor.c]
2023-03-07 Write some dubug print statements
2023-03-08 Fix the prev state issue.
    [ComeBackSM.c, DCMotor.c, GoToBranchOriginSM.c, GoToBranchOriginSM.h, PushCommitSM.c, TopHSM.c]
2023-03-08 Adjust left and right motors with button presses.
    [follower.kicad_sch, schematics.kicad_sch]
2023-03-08 Update kicad schematic and comment out Test Harness prints.
    [follower.kicad_sch, schematics.kicad_sch]
2023-03-08 Use distance buckets in getDesiredBranchDistance. Remove adjust logic. Use distance slider in PushCommit.
2023-03-08 2 stage speed for push and come back. Faster rotations. Wider branch switch bins.
2023-03-09 3 stage ramp up. Tuning.
    * In calibration forward, left motor jumps much farther than right. Reduce calibration forward speed.
    * Lspeed at 160+ RPM undershoots actual. Increase its fast kI.
    * Ramp up shorter distances.
    * Stop between forward and reverse during calibration and in branch.
    * Slow down rotation speed for reliability.
    * Re-calibrate rotation to cm to drive conversion.
    * Re-calibrate length of branch in getDesiredBranchDistance.
    [CalibrationSM.c, ComeBackSM.c, ComeBackSM.h, DCMotor.c, DistanceSlider.c, ES_Configure.h, PushCommitSM.c, PushCommitSM.h]
2023-03-09 Double speed of SPI communication to reduce false negatives by ~6x.
2023-03-13 Add holes for motor drivers, servo to robot assem, create CAD for heart
    [DEV_bottom_board.SLDPRT, NEW_wheel_assem.SLDASM, drive_shaft.SLDPRT, heart.SLDPRT, left_heart.SLDPRT, left_heart.STL, motor_driver_board.SLDPRT, power_switch.SLDPRT]
2023-03-14 Add encoder mounts to the CAD
    [Encoder_BracketMount.SLDPRT, NEW_wheel_assem.SLDASM, limit_switch.SLDPRT]
2023-03-14 Update KiCad with new circuits, add screenshots for the website
    [IR_Beacon.kicad_sch, follower.kicad_sch, schematics.kicad_sch]
2023-03-14 Update CAD
    * Protoboards for cap touch, LEDs
    * Cap touch
    * Add nuts and bolts for bumper mounts
    [5v_battery.SLDPRT, DEV_bottom_board.SLDPRT, Encoder_BracketMount.SLDPRT, NEW_wheel_assem.SLDASM, cap_touch.SLDPRT, large_protoboard_adafruit.SLDPRT, limit_switch.SLDPRT, protoboard.SLDPRT]
2023-03-14 Update KiCAD and CAD
    * Moved input line to PIC for branch and distance switch circuits
    [NEW_top_plate.SLDPRT, follower.kicad_sch, reflect_assem.SLDASM, reflectance_holder.SLDPRT, schematics.kicad_sch]
